LuisDonatien/TFG/README.md

# TFG
Control digital en HW de motor DC con UI Microblaze.
