LuisDonatien/TFG/Programacion/SoCNexys4/Hw/BD/SoCNexys/ip/SoCNexys_Controlador_Motores_0_0/synth/SoCNexys_Controlador_Motores_0_0.vhd

-- (c) Copyright 1995-2022 Xilinx, Inc. All rights reserved.
-- 
-- This file contains confidential and proprietary information
-- of Xilinx, Inc. and is protected under U.S. and
-- international copyright and other intellectual property
-- laws.
-- 
-- DISCLAIMER
-- This disclaimer is not a license and does not grant any
-- rights to the materials distributed herewith. Except as
-- otherwise provided in a valid license issued to you by
-- Xilinx, and to the maximum extent permitted by applicable
-- law: (1) THESE MATERIALS ARE MADE AVAILABLE "AS IS" AND
-- WITH ALL FAULTS, AND XILINX HEREBY DISCLAIMS ALL WARRANTIES
-- AND CONDITIONS, EXPRESS, IMPLIED, OR STATUTORY, INCLUDING
-- BUT NOT LIMITED TO WARRANTIES OF MERCHANTABILITY, NON-
-- INFRINGEMENT, OR FITNESS FOR ANY PARTICULAR PURPOSE; and
-- (2) Xilinx shall not be liable (whether in contract or tort,
-- including negligence, or under any other theory of
-- liability) for any loss or damage of any kind or nature
-- related to, arising under or in connection with these
-- materials, including for any direct, or any indirect,
-- special, incidental, or consequential loss or damage
-- (including loss of data, profits, goodwill, or any type of
-- loss or damage suffered as a result of any action brought
-- by a third party) even if such damage or loss was
-- reasonably foreseeable or Xilinx had been advised of the
-- possibility of the same.
-- 
-- CRITICAL APPLICATIONS
-- Xilinx products are not designed or intended to be fail-
-- safe, or for use in any application requiring fail-safe
-- performance, such as life-support or safety devices or
-- systems, Class III medical devices, nuclear facilities,
-- applications related to the deployment of airbags, or any
-- other applications that could lead to death, personal
-- injury, or severe property or environmental damage
-- (individually and collectively, "Critical
-- Applications"). Customer assumes the sole risk and
-- liability of any use of Xilinx products in Critical
-- Applications, subject only to applicable laws and
-- regulations governing limitations on product liability.
-- 
-- THIS COPYRIGHT NOTICE AND DISCLAIMER MUST BE RETAINED AS
-- PART OF THIS FILE AT ALL TIMES.
-- 
-- DO NOT MODIFY THIS FILE.

-- IP VLNV: xilinx.com:user:Controlador_Motores_BLDC:1.0
-- IP Revision: 21

LIBRARY ieee;
USE ieee.std_logic_1164.ALL;
USE ieee.numeric_std.ALL;

ENTITY SoCNexys_Controlador_Motores_0_0 IS
  PORT (
    CLK : IN STD_LOGIC;
    RESET : IN STD_LOGIC;
    A : IN STD_LOGIC;
    B : IN STD_LOGIC;
    C : IN STD_LOGIC;
    A_out : OUT STD_LOGIC;
    B_out : OUT STD_LOGIC;
    C_out : OUT STD_LOGIC;
    PWM_AH : OUT STD_LOGIC;
    PWM_AL : OUT STD_LOGIC;
    PWM_BH : OUT STD_LOGIC;
    PWM_BL : OUT STD_LOGIC;
    PWM_CH : OUT STD_LOGIC;
    PWM_CL : OUT STD_LOGIC;
    PWM_HIGH : OUT STD_LOGIC;
    PWM_LOW : OUT STD_LOGIC;
    ERROR : OUT STD_LOGIC;
    Duty_Led : OUT STD_LOGIC_VECTOR(9 DOWNTO 0);
    Intc : OUT STD_LOGIC;
    Segment : OUT STD_LOGIC_VECTOR(6 DOWNTO 0);
    Display : OUT STD_LOGIC_VECTOR(3 DOWNTO 0);
    s00_axi_aclk : IN STD_LOGIC;
    s00_axi_aresetn : IN STD_LOGIC;
    s00_axi_awaddr : IN STD_LOGIC_VECTOR(4 DOWNTO 0);
    s00_axi_awprot : IN STD_LOGIC_VECTOR(2 DOWNTO 0);
    s00_axi_awvalid : IN STD_LOGIC;
    s00_axi_awready : OUT STD_LOGIC;
    s00_axi_wdata : IN STD_LOGIC_VECTOR(31 DOWNTO 0);
    s00_axi_wstrb : IN STD_LOGIC_VECTOR(3 DOWNTO 0);
    s00_axi_wvalid : IN STD_LOGIC;
    s00_axi_wready : OUT STD_LOGIC;
    s00_axi_bresp : OUT STD_LOGIC_VECTOR(1 DOWNTO 0);
    s00_axi_bvalid : OUT STD_LOGIC;
    s00_axi_bready : IN STD_LOGIC;
    s00_axi_araddr : IN STD_LOGIC_VECTOR(4 DOWNTO 0);
    s00_axi_arprot : IN STD_LOGIC_VECTOR(2 DOWNTO 0);
    s00_axi_arvalid : IN STD_LOGIC;
    s00_axi_arready : OUT STD_LOGIC;
    s00_axi_rdata : OUT STD_LOGIC_VECTOR(31 DOWNTO 0);
    s00_axi_rresp : OUT STD_LOGIC_VECTOR(1 DOWNTO 0);
    s00_axi_rvalid : OUT STD_LOGIC;
    s00_axi_rready : IN STD_LOGIC
  );
END SoCNexys_Controlador_Motores_0_0;

ARCHITECTURE SoCNexys_Controlador_Motores_0_0_arch OF SoCNexys_Controlador_Motores_0_0 IS
  ATTRIBUTE DowngradeIPIdentifiedWarnings : STRING;
  ATTRIBUTE DowngradeIPIdentifiedWarnings OF SoCNexys_Controlador_Motores_0_0_arch: ARCHITECTURE IS "yes";
  COMPONENT Controlador_Motores_BLDC_v1_0 IS
    GENERIC (
      C_S00_AXI_DATA_WIDTH : INTEGER; -- Width of S_AXI data bus
      C_S00_AXI_ADDR_WIDTH : INTEGER; -- Width of S_AXI address bus
      CONTROLADOR : BOOLEAN;
      DIRECTO : BOOLEAN;
      KP : INTEGER;
      KI : INTEGER;
      SAMPLES : INTEGER;
      COMPLEMENTARIO : BOOLEAN;
      Duty_SIZE : INTEGER;
      DeadBand : INTEGER;
      Frecuencia : INTEGER;
      Ciclos : INTEGER
    );
    PORT (
      CLK : IN STD_LOGIC;
      RESET : IN STD_LOGIC;
      A : IN STD_LOGIC;
      B : IN STD_LOGIC;
      C : IN STD_LOGIC;
      A_out : OUT STD_LOGIC;
      B_out : OUT STD_LOGIC;
      C_out : OUT STD_LOGIC;
      PWM_AH : OUT STD_LOGIC;
      PWM_AL : OUT STD_LOGIC;
      PWM_BH : OUT STD_LOGIC;
      PWM_BL : OUT STD_LOGIC;
      PWM_CH : OUT STD_LOGIC;
      PWM_CL : OUT STD_LOGIC;
      PWM_HIGH : OUT STD_LOGIC;
      PWM_LOW : OUT STD_LOGIC;
      ERROR : OUT STD_LOGIC;
      Duty_Led : OUT STD_LOGIC_VECTOR(9 DOWNTO 0);
      Intc : OUT STD_LOGIC;
      Segment : OUT STD_LOGIC_VECTOR(6 DOWNTO 0);
      Display : OUT STD_LOGIC_VECTOR(3 DOWNTO 0);
      s00_axi_aclk : IN STD_LOGIC;
      s00_axi_aresetn : IN STD_LOGIC;
      s00_axi_awaddr : IN STD_LOGIC_VECTOR(4 DOWNTO 0);
      s00_axi_awprot : IN STD_LOGIC_VECTOR(2 DOWNTO 0);
      s00_axi_awvalid : IN STD_LOGIC;
      s00_axi_awready : OUT STD_LOGIC;
      s00_axi_wdata : IN STD_LOGIC_VECTOR(31 DOWNTO 0);
      s00_axi_wstrb : IN STD_LOGIC_VECTOR(3 DOWNTO 0);
      s00_axi_wvalid : IN STD_LOGIC;
      s00_axi_wready : OUT STD_LOGIC;
      s00_axi_bresp : OUT STD_LOGIC_VECTOR(1 DOWNTO 0);
      s00_axi_bvalid : OUT STD_LOGIC;
      s00_axi_bready : IN STD_LOGIC;
      s00_axi_araddr : IN STD_LOGIC_VECTOR(4 DOWNTO 0);
      s00_axi_arprot : IN STD_LOGIC_VECTOR(2 DOWNTO 0);
      s00_axi_arvalid : IN STD_LOGIC;
      s00_axi_arready : OUT STD_LOGIC;
      s00_axi_rdata : OUT STD_LOGIC_VECTOR(31 DOWNTO 0);
      s00_axi_rresp : OUT STD_LOGIC_VECTOR(1 DOWNTO 0);
      s00_axi_rvalid : OUT STD_LOGIC;
      s00_axi_rready : IN STD_LOGIC
    );
  END COMPONENT Controlador_Motores_BLDC_v1_0;
  ATTRIBUTE X_CORE_INFO : STRING;
  ATTRIBUTE X_CORE_INFO OF SoCNexys_Controlador_Motores_0_0_arch: ARCHITECTURE IS "Controlador_Motores_BLDC_v1_0,Vivado 2020.1";
  ATTRIBUTE CHECK_LICENSE_TYPE : STRING;
  ATTRIBUTE CHECK_LICENSE_TYPE OF SoCNexys_Controlador_Motores_0_0_arch : ARCHITECTURE IS "SoCNexys_Controlador_Motores_0_0,Controlador_Motores_BLDC_v1_0,{}";
  ATTRIBUTE CORE_GENERATION_INFO : STRING;
  ATTRIBUTE CORE_GENERATION_INFO OF SoCNexys_Controlador_Motores_0_0_arch: ARCHITECTURE IS "SoCNexys_Controlador_Motores_0_0,Controlador_Motores_BLDC_v1_0,{x_ipProduct=Vivado 2020.1,x_ipVendor=xilinx.com,x_ipLibrary=user,x_ipName=Controlador_Motores_BLDC,x_ipVersion=1.0,x_ipCoreRevision=21,x_ipLanguage=VHDL,x_ipSimLanguage=MIXED,C_S00_AXI_DATA_WIDTH=32,C_S00_AXI_ADDR_WIDTH=5,CONTROLADOR=TRUE,DIRECTO=FALSE,KP=125,KI=5,SAMPLES=40,COMPLEMENTARIO=true,Duty_SIZE=10,DeadBand=4,Frecuencia=1000,Ciclos=5}";
  ATTRIBUTE X_INTERFACE_INFO : STRING;
  ATTRIBUTE X_INTERFACE_PARAMETER : STRING;
  ATTRIBUTE X_INTERFACE_INFO OF s00_axi_rready: SIGNAL IS "xilinx.com:interface:aximm:1.0 S00_AXI RREADY";
  ATTRIBUTE X_INTERFACE_INFO OF s00_axi_rvalid: SIGNAL IS "xilinx.com:interface:aximm:1.0 S00_AXI RVALID";
  ATTRIBUTE X_INTERFACE_INFO OF s00_axi_rresp: SIGNAL IS "xilinx.com:interface:aximm:1.0 S00_AXI RRESP";
  ATTRIBUTE X_INTERFACE_INFO OF s00_axi_rdata: SIGNAL IS "xilinx.com:interface:aximm:1.0 S00_AXI RDATA";
  ATTRIBUTE X_INTERFACE_INFO OF s00_axi_arready: SIGNAL IS "xilinx.com:interface:aximm:1.0 S00_AXI ARREADY";
  ATTRIBUTE X_INTERFACE_INFO OF s00_axi_arvalid: SIGNAL IS "xilinx.com:interface:aximm:1.0 S00_AXI ARVALID";
  ATTRIBUTE X_INTERFACE_INFO OF s00_axi_arprot: SIGNAL IS "xilinx.com:interface:aximm:1.0 S00_AXI ARPROT";
  ATTRIBUTE X_INTERFACE_INFO OF s00_axi_araddr: SIGNAL IS "xilinx.com:interface:aximm:1.0 S00_AXI ARADDR";
  ATTRIBUTE X_INTERFACE_INFO OF s00_axi_bready: SIGNAL IS "xilinx.com:interface:aximm:1.0 S00_AXI BREADY";
  ATTRIBUTE X_INTERFACE_INFO OF s00_axi_bvalid: SIGNAL IS "xilinx.com:interface:aximm:1.0 S00_AXI BVALID";
  ATTRIBUTE X_INTERFACE_INFO OF s00_axi_bresp: SIGNAL IS "xilinx.com:interface:aximm:1.0 S00_AXI BRESP";
  ATTRIBUTE X_INTERFACE_INFO OF s00_axi_wready: SIGNAL IS "xilinx.com:interface:aximm:1.0 S00_AXI WREADY";
  ATTRIBUTE X_INTERFACE_INFO OF s00_axi_wvalid: SIGNAL IS "xilinx.com:interface:aximm:1.0 S00_AXI WVALID";
  ATTRIBUTE X_INTERFACE_INFO OF s00_axi_wstrb: SIGNAL IS "xilinx.com:interface:aximm:1.0 S00_AXI WSTRB";
  ATTRIBUTE X_INTERFACE_INFO OF s00_axi_wdata: SIGNAL IS "xilinx.com:interface:aximm:1.0 S00_AXI WDATA";
  ATTRIBUTE X_INTERFACE_INFO OF s00_axi_awready: SIGNAL IS "xilinx.com:interface:aximm:1.0 S00_AXI AWREADY";
  ATTRIBUTE X_INTERFACE_INFO OF s00_axi_awvalid: SIGNAL IS "xilinx.com:interface:aximm:1.0 S00_AXI AWVALID";
  ATTRIBUTE X_INTERFACE_INFO OF s00_axi_awprot: SIGNAL IS "xilinx.com:interface:aximm:1.0 S00_AXI AWPROT";
  ATTRIBUTE X_INTERFACE_PARAMETER OF s00_axi_awaddr: SIGNAL IS "XIL_INTERFACENAME S00_AXI, WIZ_DATA_WIDTH 32, WIZ_NUM_REG 6, SUPPORTS_NARROW_BURST 0, DATA_WIDTH 32, PROTOCOL AXI4LITE, FREQ_HZ 100000000, ID_WIDTH 0, ADDR_WIDTH 5, AWUSER_WIDTH 0, ARUSER_WIDTH 0, WUSER_WIDTH 0, RUSER_WIDTH 0, BUSER_WIDTH 0, READ_WRITE_MODE READ_WRITE, HAS_BURST 0, HAS_LOCK 0, HAS_PROT 1, HAS_CACHE 0, HAS_QOS 0, HAS_REGION 0, HAS_WSTRB 1, HAS_BRESP 1, HAS_RRESP 1, NUM_READ_OUTSTANDING 2, NUM_WRITE_OUTSTANDING 2, MAX_BURST_LENGTH 1, PHASE 0.0, CLK_DOMAIN /clk_wiz_0_clk_out1, NUM_" & 
"READ_THREADS 1, NUM_WRITE_THREADS 1, RUSER_BITS_PER_BYTE 0, WUSER_BITS_PER_BYTE 0, INSERT_VIP 0";
  ATTRIBUTE X_INTERFACE_INFO OF s00_axi_awaddr: SIGNAL IS "xilinx.com:interface:aximm:1.0 S00_AXI AWADDR";
  ATTRIBUTE X_INTERFACE_PARAMETER OF s00_axi_aresetn: SIGNAL IS "XIL_INTERFACENAME S00_AXI_RST, POLARITY ACTIVE_LOW, INSERT_VIP 0";
  ATTRIBUTE X_INTERFACE_INFO OF s00_axi_aresetn: SIGNAL IS "xilinx.com:signal:reset:1.0 S00_AXI_RST RST";
  ATTRIBUTE X_INTERFACE_PARAMETER OF s00_axi_aclk: SIGNAL IS "XIL_INTERFACENAME S00_AXI_CLK, ASSOCIATED_BUSIF S00_AXI, ASSOCIATED_RESET s00_axi_aresetn, FREQ_HZ 100000000, FREQ_TOLERANCE_HZ 0, PHASE 0.0, CLK_DOMAIN /clk_wiz_0_clk_out1, INSERT_VIP 0, PortWidth 1";
  ATTRIBUTE X_INTERFACE_INFO OF s00_axi_aclk: SIGNAL IS "xilinx.com:signal:clock:1.0 S00_AXI_CLK CLK";
  ATTRIBUTE X_INTERFACE_PARAMETER OF Intc: SIGNAL IS "XIL_INTERFACENAME Intc, SENSITIVITY EDGE_RISING, PortWidth 1";
  ATTRIBUTE X_INTERFACE_INFO OF Intc: SIGNAL IS "xilinx.com:signal:interrupt:1.0 Intc INTERRUPT";
  ATTRIBUTE X_INTERFACE_PARAMETER OF RESET: SIGNAL IS "XIL_INTERFACENAME RESET, POLARITY ACTIVE_HIGH, PortWidth 1, TYPE rst, INSERT_VIP 0";
  ATTRIBUTE X_INTERFACE_INFO OF RESET: SIGNAL IS "xilinx.com:signal:reset:1.0 RESET RST";
  ATTRIBUTE X_INTERFACE_PARAMETER OF CLK: SIGNAL IS "XIL_INTERFACENAME CLK, ASSOCIATED_BUSIF CLK, PortWidth 1, FREQ_HZ 100000000, FREQ_TOLERANCE_HZ 0, PHASE 0.0, CLK_DOMAIN /clk_wiz_0_clk_out1, INSERT_VIP 0";
  ATTRIBUTE X_INTERFACE_INFO OF CLK: SIGNAL IS "xilinx.com:signal:clock:1.0 CLK CLK";
BEGIN
  U0 : Controlador_Motores_BLDC_v1_0
    GENERIC MAP (
      C_S00_AXI_DATA_WIDTH => 32,
      C_S00_AXI_ADDR_WIDTH => 5,
      CONTROLADOR => true,
      DIRECTO => false,
      KP => 125,
      KI => 5,
      SAMPLES => 40,
      COMPLEMENTARIO => true,
      Duty_SIZE => 10,
      DeadBand => 4,
      Frecuencia => 1000,
      Ciclos => 5
    )
    PORT MAP (
      CLK => CLK,
      RESET => RESET,
      A => A,
      B => B,
      C => C,
      A_out => A_out,
      B_out => B_out,
      C_out => C_out,
      PWM_AH => PWM_AH,
      PWM_AL => PWM_AL,
      PWM_BH => PWM_BH,
      PWM_BL => PWM_BL,
      PWM_CH => PWM_CH,
      PWM_CL => PWM_CL,
      PWM_HIGH => PWM_HIGH,
      PWM_LOW => PWM_LOW,
      ERROR => ERROR,
      Duty_Led => Duty_Led,
      Intc => Intc,
      Segment => Segment,
      Display => Display,
      s00_axi_aclk => s00_axi_aclk,
      s00_axi_aresetn => s00_axi_aresetn,
      s00_axi_awaddr => s00_axi_awaddr,
      s00_axi_awprot => s00_axi_awprot,
      s00_axi_awvalid => s00_axi_awvalid,
      s00_axi_awready => s00_axi_awready,
      s00_axi_wdata => s00_axi_wdata,
      s00_axi_wstrb => s00_axi_wstrb,
      s00_axi_wvalid => s00_axi_wvalid,
      s00_axi_wready => s00_axi_wready,
      s00_axi_bresp => s00_axi_bresp,
      s00_axi_bvalid => s00_axi_bvalid,
      s00_axi_bready => s00_axi_bready,
      s00_axi_araddr => s00_axi_araddr,
      s00_axi_arprot => s00_axi_arprot,
      s00_axi_arvalid => s00_axi_arvalid,
      s00_axi_arready => s00_axi_arready,
      s00_axi_rdata => s00_axi_rdata,
      s00_axi_rresp => s00_axi_rresp,
      s00_axi_rvalid => s00_axi_rvalid,
      s00_axi_rready => s00_axi_rready
    );
END SoCNexys_Controlador_Motores_0_0_arch;
