LuisDonatien/TFG/Programacion/SoCNexys4/Hw/BD/SoCNexys/ip/SoCNexys_microblaze_0_0/SoCNexys_microblaze_0_0_stub.v

// Copyright 1986-2020 Xilinx, Inc. All Rights Reserved.
// --------------------------------------------------------------------------------
// Tool Version: Vivado v.2020.1 (win64) Build 2902540 Wed May 27 19:54:49 MDT 2020
// Date        : Thu Jun 23 02:34:39 2022
// Host        : LAPTOP-NOM20D60 running 64-bit major release  (build 9200)
// Command     : write_verilog -force -mode synth_stub
//               c:/GitHubTFG/TFG/Programacion/SoCNexys4/Hw/BD/SoCNexys/ip/SoCNexys_microblaze_0_0/SoCNexys_microblaze_0_0_stub.v
// Design      : SoCNexys_microblaze_0_0
// Purpose     : Stub declaration of top-level module interface
// Device      : xc7a100tcsg324-1
// --------------------------------------------------------------------------------

// This empty module with port declaration file causes synthesis tools to infer a black box for IP.
// The synthesis directives are for Synopsys Synplify support to prevent IO buffer insertion.
// Please paste the declaration into a Verilog source file or add the file as an additional source.
(* x_core_info = "MicroBlaze,Vivado 2020.1" *)
module SoCNexys_microblaze_0_0(Clk, Reset, Interrupt, Interrupt_Address, 
  Interrupt_Ack, Instr_Addr, Instr, IFetch, I_AS, IReady, IWAIT, ICE, IUE, Data_Addr, Data_Read, 
  Data_Write, D_AS, Read_Strobe, Write_Strobe, DReady, DWait, DCE, DUE, Byte_Enable, M_AXI_DP_AWADDR, 
  M_AXI_DP_AWPROT, M_AXI_DP_AWVALID, M_AXI_DP_AWREADY, M_AXI_DP_WDATA, M_AXI_DP_WSTRB, 
  M_AXI_DP_WVALID, M_AXI_DP_WREADY, M_AXI_DP_BRESP, M_AXI_DP_BVALID, M_AXI_DP_BREADY, 
  M_AXI_DP_ARADDR, M_AXI_DP_ARPROT, M_AXI_DP_ARVALID, M_AXI_DP_ARREADY, M_AXI_DP_RDATA, 
  M_AXI_DP_RRESP, M_AXI_DP_RVALID, M_AXI_DP_RREADY, Dbg_Clk, Dbg_TDI, Dbg_TDO, Dbg_Reg_En, 
  Dbg_Shift, Dbg_Capture, Dbg_Update, Debug_Rst, Dbg_Disable)
/* synthesis syn_black_box black_box_pad_pin="Clk,Reset,Interrupt,Interrupt_Address[0:31],Interrupt_Ack[0:1],Instr_Addr[0:31],Instr[0:31],IFetch,I_AS,IReady,IWAIT,ICE,IUE,Data_Addr[0:31],Data_Read[0:31],Data_Write[0:31],D_AS,Read_Strobe,Write_Strobe,DReady,DWait,DCE,DUE,Byte_Enable[0:3],M_AXI_DP_AWADDR[31:0],M_AXI_DP_AWPROT[2:0],M_AXI_DP_AWVALID,M_AXI_DP_AWREADY,M_AXI_DP_WDATA[31:0],M_AXI_DP_WSTRB[3:0],M_AXI_DP_WVALID,M_AXI_DP_WREADY,M_AXI_DP_BRESP[1:0],M_AXI_DP_BVALID,M_AXI_DP_BREADY,M_AXI_DP_ARADDR[31:0],M_AXI_DP_ARPROT[2:0],M_AXI_DP_ARVALID,M_AXI_DP_ARREADY,M_AXI_DP_RDATA[31:0],M_AXI_DP_RRESP[1:0],M_AXI_DP_RVALID,M_AXI_DP_RREADY,Dbg_Clk,Dbg_TDI,Dbg_TDO,Dbg_Reg_En[0:7],Dbg_Shift,Dbg_Capture,Dbg_Update,Debug_Rst,Dbg_Disable" */;
  input Clk;
  input Reset;
  input Interrupt;
  input [0:31]Interrupt_Address;
  output [0:1]Interrupt_Ack;
  output [0:31]Instr_Addr;
  input [0:31]Instr;
  output IFetch;
  output I_AS;
  input IReady;
  input IWAIT;
  input ICE;
  input IUE;
  output [0:31]Data_Addr;
  input [0:31]Data_Read;
  output [0:31]Data_Write;
  output D_AS;
  output Read_Strobe;
  output Write_Strobe;
  input DReady;
  input DWait;
  input DCE;
  input DUE;
  output [0:3]Byte_Enable;
  output [31:0]M_AXI_DP_AWADDR;
  output [2:0]M_AXI_DP_AWPROT;
  output M_AXI_DP_AWVALID;
  input M_AXI_DP_AWREADY;
  output [31:0]M_AXI_DP_WDATA;
  output [3:0]M_AXI_DP_WSTRB;
  output M_AXI_DP_WVALID;
  input M_AXI_DP_WREADY;
  input [1:0]M_AXI_DP_BRESP;
  input M_AXI_DP_BVALID;
  output M_AXI_DP_BREADY;
  output [31:0]M_AXI_DP_ARADDR;
  output [2:0]M_AXI_DP_ARPROT;
  output M_AXI_DP_ARVALID;
  input M_AXI_DP_ARREADY;
  input [31:0]M_AXI_DP_RDATA;
  input [1:0]M_AXI_DP_RRESP;
  input M_AXI_DP_RVALID;
  output M_AXI_DP_RREADY;
  input Dbg_Clk;
  input Dbg_TDI;
  output Dbg_TDO;
  input [0:7]Dbg_Reg_En;
  input Dbg_Shift;
  input Dbg_Capture;
  input Dbg_Update;
  input Debug_Rst;
  input Dbg_Disable;
endmodule
