LuisDonatien/TFG/Programacion/SoCNexys4/Hw/BD/SoCNexys/ip/SoCNexys_clk_wiz_0_0/SoCNexys_clk_wiz_0_0_stub.vhdl

-- Copyright 1986-2020 Xilinx, Inc. All Rights Reserved.
-- --------------------------------------------------------------------------------
-- Tool Version: Vivado v.2020.1 (win64) Build 2902540 Wed May 27 19:54:49 MDT 2020
-- Date        : Thu Jun 23 02:34:01 2022
-- Host        : LAPTOP-NOM20D60 running 64-bit major release  (build 9200)
-- Command     : write_vhdl -force -mode synth_stub
--               c:/GitHubTFG/TFG/Programacion/SoCNexys4/Hw/BD/SoCNexys/ip/SoCNexys_clk_wiz_0_0/SoCNexys_clk_wiz_0_0_stub.vhdl
-- Design      : SoCNexys_clk_wiz_0_0
-- Purpose     : Stub declaration of top-level module interface
-- Device      : xc7a100tcsg324-1
-- --------------------------------------------------------------------------------
library IEEE;
use IEEE.STD_LOGIC_1164.ALL;

entity SoCNexys_clk_wiz_0_0 is
  Port ( 
    clk_out1 : out STD_LOGIC;
    reset : in STD_LOGIC;
    locked : out STD_LOGIC;
    clk_in1 : in STD_LOGIC
  );

end SoCNexys_clk_wiz_0_0;

architecture stub of SoCNexys_clk_wiz_0_0 is
attribute syn_black_box : boolean;
attribute black_box_pad_pin : string;
attribute syn_black_box of stub : architecture is true;
attribute black_box_pad_pin of stub : architecture is "clk_out1,reset,locked,clk_in1";
begin
end;
