LuisDonatien/TFG/Programacion/SoCBasys3/Hw/BD/SoC/ip/SoC_axi_uartlite_0_0/SoC_axi_uartlite_0_0_stub.v

// Copyright 1986-2020 Xilinx, Inc. All Rights Reserved.
// --------------------------------------------------------------------------------
// Tool Version: Vivado v.2020.1 (win64) Build 2902540 Wed May 27 19:54:49 MDT 2020
// Date        : Thu Jun  2 19:59:40 2022
// Host        : LAPTOP-NOM20D60 running 64-bit major release  (build 9200)
// Command     : write_verilog -force -mode synth_stub
//               c:/GitHubTFG/TFG/Programacion/SoCBasys3/BD/SoC/ip/SoC_axi_uartlite_0_0/SoC_axi_uartlite_0_0_stub.v
// Design      : SoC_axi_uartlite_0_0
// Purpose     : Stub declaration of top-level module interface
// Device      : xc7a35tcpg236-1
// --------------------------------------------------------------------------------

// This empty module with port declaration file causes synthesis tools to infer a black box for IP.
// The synthesis directives are for Synopsys Synplify support to prevent IO buffer insertion.
// Please paste the declaration into a Verilog source file or add the file as an additional source.
(* x_core_info = "axi_uartlite,Vivado 2020.1" *)
module SoC_axi_uartlite_0_0(s_axi_aclk, s_axi_aresetn, interrupt, 
  s_axi_awaddr, s_axi_awvalid, s_axi_awready, s_axi_wdata, s_axi_wstrb, s_axi_wvalid, 
  s_axi_wready, s_axi_bresp, s_axi_bvalid, s_axi_bready, s_axi_araddr, s_axi_arvalid, 
  s_axi_arready, s_axi_rdata, s_axi_rresp, s_axi_rvalid, s_axi_rready, rx, tx)
/* synthesis syn_black_box black_box_pad_pin="s_axi_aclk,s_axi_aresetn,interrupt,s_axi_awaddr[3:0],s_axi_awvalid,s_axi_awready,s_axi_wdata[31:0],s_axi_wstrb[3:0],s_axi_wvalid,s_axi_wready,s_axi_bresp[1:0],s_axi_bvalid,s_axi_bready,s_axi_araddr[3:0],s_axi_arvalid,s_axi_arready,s_axi_rdata[31:0],s_axi_rresp[1:0],s_axi_rvalid,s_axi_rready,rx,tx" */;
  input s_axi_aclk;
  input s_axi_aresetn;
  output interrupt;
  input [3:0]s_axi_awaddr;
  input s_axi_awvalid;
  output s_axi_awready;
  input [31:0]s_axi_wdata;
  input [3:0]s_axi_wstrb;
  input s_axi_wvalid;
  output s_axi_wready;
  output [1:0]s_axi_bresp;
  output s_axi_bvalid;
  input s_axi_bready;
  input [3:0]s_axi_araddr;
  input s_axi_arvalid;
  output s_axi_arready;
  output [31:0]s_axi_rdata;
  output [1:0]s_axi_rresp;
  output s_axi_rvalid;
  input s_axi_rready;
  input rx;
  output tx;
endmodule
