LuisDonatien/TFG/Programacion/SoCNexys4/Hw/BD/SoCNexys/ip/SoCNexys_Controlador_Motores_0_0/SoCNexys_Controlador_Motores_0_0_sim_netlist.v

// Copyright 1986-2020 Xilinx, Inc. All Rights Reserved.
// --------------------------------------------------------------------------------
// Tool Version: Vivado v.2020.1 (win64) Build 2902540 Wed May 27 19:54:49 MDT 2020
// Date        : Thu Jun 23 02:48:42 2022
// Host        : LAPTOP-NOM20D60 running 64-bit major release  (build 9200)
// Command     : write_verilog -force -mode funcsim
//               c:/GitHubTFG/TFG/Programacion/SoCNexys4/Hw/BD/SoCNexys/ip/SoCNexys_Controlador_Motores_0_0/SoCNexys_Controlador_Motores_0_0_sim_netlist.v
// Design      : SoCNexys_Controlador_Motores_0_0
// Purpose     : This verilog netlist is a functional simulation representation of the design and should not be modified
//               or synthesized. This netlist cannot be used for SDF annotated simulation.
// Device      : xc7a100tcsg324-1
// --------------------------------------------------------------------------------
`timescale 1 ps / 1 ps

(* CHECK_LICENSE_TYPE = "SoCNexys_Controlador_Motores_0_0,Controlador_Motores_BLDC_v1_0,{}" *) (* downgradeipidentifiedwarnings = "yes" *) (* x_core_info = "Controlador_Motores_BLDC_v1_0,Vivado 2020.1" *) 
(* NotValidForBitStream *)
module SoCNexys_Controlador_Motores_0_0
   (CLK,
    RESET,
    A,
    B,
    C,
    A_out,
    B_out,
    C_out,
    PWM_AH,
    PWM_AL,
    PWM_BH,
    PWM_BL,
    PWM_CH,
    PWM_CL,
    PWM_HIGH,
    PWM_LOW,
    ERROR,
    Duty_Led,
    Intc,
    Segment,
    Display,
    s00_axi_aclk,
    s00_axi_aresetn,
    s00_axi_awaddr,
    s00_axi_awprot,
    s00_axi_awvalid,
    s00_axi_awready,
    s00_axi_wdata,
    s00_axi_wstrb,
    s00_axi_wvalid,
    s00_axi_wready,
    s00_axi_bresp,
    s00_axi_bvalid,
    s00_axi_bready,
    s00_axi_araddr,
    s00_axi_arprot,
    s00_axi_arvalid,
    s00_axi_arready,
    s00_axi_rdata,
    s00_axi_rresp,
    s00_axi_rvalid,
    s00_axi_rready);
  (* x_interface_info = "xilinx.com:signal:clock:1.0 CLK CLK" *) (* x_interface_parameter = "XIL_INTERFACENAME CLK, ASSOCIATED_BUSIF CLK, PortWidth 1, FREQ_HZ 100000000, FREQ_TOLERANCE_HZ 0, PHASE 0.0, CLK_DOMAIN /clk_wiz_0_clk_out1, INSERT_VIP 0" *) input CLK;
  (* x_interface_info = "xilinx.com:signal:reset:1.0 RESET RST" *) (* x_interface_parameter = "XIL_INTERFACENAME RESET, POLARITY ACTIVE_HIGH, PortWidth 1, TYPE rst, INSERT_VIP 0" *) input RESET;
  input A;
  input B;
  input C;
  output A_out;
  output B_out;
  output C_out;
  output PWM_AH;
  output PWM_AL;
  output PWM_BH;
  output PWM_BL;
  output PWM_CH;
  output PWM_CL;
  output PWM_HIGH;
  output PWM_LOW;
  output ERROR;
  output [9:0]Duty_Led;
  (* x_interface_info = "xilinx.com:signal:interrupt:1.0 Intc INTERRUPT" *) (* x_interface_parameter = "XIL_INTERFACENAME Intc, SENSITIVITY EDGE_RISING, PortWidth 1" *) output Intc;
  output [6:0]Segment;
  output [3:0]Display;
  (* x_interface_info = "xilinx.com:signal:clock:1.0 S00_AXI_CLK CLK" *) (* x_interface_parameter = "XIL_INTERFACENAME S00_AXI_CLK, ASSOCIATED_BUSIF S00_AXI, ASSOCIATED_RESET s00_axi_aresetn, FREQ_HZ 100000000, FREQ_TOLERANCE_HZ 0, PHASE 0.0, CLK_DOMAIN /clk_wiz_0_clk_out1, INSERT_VIP 0, PortWidth 1" *) input s00_axi_aclk;
  (* x_interface_info = "xilinx.com:signal:reset:1.0 S00_AXI_RST RST" *) (* x_interface_parameter = "XIL_INTERFACENAME S00_AXI_RST, POLARITY ACTIVE_LOW, INSERT_VIP 0" *) input s00_axi_aresetn;
  (* x_interface_info = "xilinx.com:interface:aximm:1.0 S00_AXI AWADDR" *) (* x_interface_parameter = "XIL_INTERFACENAME S00_AXI, WIZ_DATA_WIDTH 32, WIZ_NUM_REG 6, SUPPORTS_NARROW_BURST 0, DATA_WIDTH 32, PROTOCOL AXI4LITE, FREQ_HZ 100000000, ID_WIDTH 0, ADDR_WIDTH 5, AWUSER_WIDTH 0, ARUSER_WIDTH 0, WUSER_WIDTH 0, RUSER_WIDTH 0, BUSER_WIDTH 0, READ_WRITE_MODE READ_WRITE, HAS_BURST 0, HAS_LOCK 0, HAS_PROT 1, HAS_CACHE 0, HAS_QOS 0, HAS_REGION 0, HAS_WSTRB 1, HAS_BRESP 1, HAS_RRESP 1, NUM_READ_OUTSTANDING 2, NUM_WRITE_OUTSTANDING 2, MAX_BURST_LENGTH 1, PHASE 0.0, CLK_DOMAIN /clk_wiz_0_clk_out1, NUM_READ_THREADS 1, NUM_WRITE_THREADS 1, RUSER_BITS_PER_BYTE 0, WUSER_BITS_PER_BYTE 0, INSERT_VIP 0" *) input [4:0]s00_axi_awaddr;
  (* x_interface_info = "xilinx.com:interface:aximm:1.0 S00_AXI AWPROT" *) input [2:0]s00_axi_awprot;
  (* x_interface_info = "xilinx.com:interface:aximm:1.0 S00_AXI AWVALID" *) input s00_axi_awvalid;
  (* x_interface_info = "xilinx.com:interface:aximm:1.0 S00_AXI AWREADY" *) output s00_axi_awready;
  (* x_interface_info = "xilinx.com:interface:aximm:1.0 S00_AXI WDATA" *) input [31:0]s00_axi_wdata;
  (* x_interface_info = "xilinx.com:interface:aximm:1.0 S00_AXI WSTRB" *) input [3:0]s00_axi_wstrb;
  (* x_interface_info = "xilinx.com:interface:aximm:1.0 S00_AXI WVALID" *) input s00_axi_wvalid;
  (* x_interface_info = "xilinx.com:interface:aximm:1.0 S00_AXI WREADY" *) output s00_axi_wready;
  (* x_interface_info = "xilinx.com:interface:aximm:1.0 S00_AXI BRESP" *) output [1:0]s00_axi_bresp;
  (* x_interface_info = "xilinx.com:interface:aximm:1.0 S00_AXI BVALID" *) output s00_axi_bvalid;
  (* x_interface_info = "xilinx.com:interface:aximm:1.0 S00_AXI BREADY" *) input s00_axi_bready;
  (* x_interface_info = "xilinx.com:interface:aximm:1.0 S00_AXI ARADDR" *) input [4:0]s00_axi_araddr;
  (* x_interface_info = "xilinx.com:interface:aximm:1.0 S00_AXI ARPROT" *) input [2:0]s00_axi_arprot;
  (* x_interface_info = "xilinx.com:interface:aximm:1.0 S00_AXI ARVALID" *) input s00_axi_arvalid;
  (* x_interface_info = "xilinx.com:interface:aximm:1.0 S00_AXI ARREADY" *) output s00_axi_arready;
  (* x_interface_info = "xilinx.com:interface:aximm:1.0 S00_AXI RDATA" *) output [31:0]s00_axi_rdata;
  (* x_interface_info = "xilinx.com:interface:aximm:1.0 S00_AXI RRESP" *) output [1:0]s00_axi_rresp;
  (* x_interface_info = "xilinx.com:interface:aximm:1.0 S00_AXI RVALID" *) output s00_axi_rvalid;
  (* x_interface_info = "xilinx.com:interface:aximm:1.0 S00_AXI RREADY" *) input s00_axi_rready;

  wire A;
  wire A_out;
  wire B;
  wire B_out;
  wire C;
  wire CLK;
  wire C_out;
  wire [3:0]Display;
  wire [9:0]Duty_Led;
  wire ERROR;
  wire Intc;
  wire PWM_AH;
  wire PWM_AL;
  wire PWM_BH;
  wire PWM_BL;
  wire PWM_CH;
  wire PWM_CL;
  wire PWM_HIGH;
  wire PWM_LOW;
  wire RESET;
  wire [6:0]Segment;
  wire s00_axi_aclk;
  wire [4:0]s00_axi_araddr;
  wire s00_axi_aresetn;
  wire [2:0]s00_axi_arprot;
  wire s00_axi_arready;
  wire s00_axi_arvalid;
  wire [4:0]s00_axi_awaddr;
  wire [2:0]s00_axi_awprot;
  wire s00_axi_awready;
  wire s00_axi_awvalid;
  wire s00_axi_bready;
  wire [1:0]s00_axi_bresp;
  wire s00_axi_bvalid;
  wire [31:0]s00_axi_rdata;
  wire s00_axi_rready;
  wire [1:0]s00_axi_rresp;
  wire s00_axi_rvalid;
  wire [31:0]s00_axi_wdata;
  wire s00_axi_wready;
  wire [3:0]s00_axi_wstrb;
  wire s00_axi_wvalid;

  (* COMPLEMENTARIO = "TRUE" *) 
  (* CONTROLADOR = "TRUE" *) 
  (* C_S00_AXI_ADDR_WIDTH = "5" *) 
  (* C_S00_AXI_DATA_WIDTH = "32" *) 
  (* Ciclos = "5" *) 
  (* DIRECTO = "FALSE" *) 
  (* DeadBand = "4" *) 
  (* Duty_SIZE = "10" *) 
  (* Frecuencia = "1000" *) 
  (* KI = "5" *) 
  (* KP = "125" *) 
  (* SAMPLES = "40" *) 
  SoCNexys_Controlador_Motores_0_0_Controlador_Motores_BLDC_v1_0 U0
       (.A(A),
        .A_out(A_out),
        .B(B),
        .B_out(B_out),
        .C(C),
        .CLK(CLK),
        .C_out(C_out),
        .Display(Display),
        .Duty_Led(Duty_Led),
        .ERROR(ERROR),
        .Intc(Intc),
        .PWM_AH(PWM_AH),
        .PWM_AL(PWM_AL),
        .PWM_BH(PWM_BH),
        .PWM_BL(PWM_BL),
        .PWM_CH(PWM_CH),
        .PWM_CL(PWM_CL),
        .PWM_HIGH(PWM_HIGH),
        .PWM_LOW(PWM_LOW),
        .RESET(RESET),
        .Segment(Segment),
        .s00_axi_aclk(s00_axi_aclk),
        .s00_axi_araddr(s00_axi_araddr),
        .s00_axi_aresetn(s00_axi_aresetn),
        .s00_axi_arprot(s00_axi_arprot),
        .s00_axi_arready(s00_axi_arready),
        .s00_axi_arvalid(s00_axi_arvalid),
        .s00_axi_awaddr(s00_axi_awaddr),
        .s00_axi_awprot(s00_axi_awprot),
        .s00_axi_awready(s00_axi_awready),
        .s00_axi_awvalid(s00_axi_awvalid),
        .s00_axi_bready(s00_axi_bready),
        .s00_axi_bresp(s00_axi_bresp),
        .s00_axi_bvalid(s00_axi_bvalid),
        .s00_axi_rdata(s00_axi_rdata),
        .s00_axi_rready(s00_axi_rready),
        .s00_axi_rresp(s00_axi_rresp),
        .s00_axi_rvalid(s00_axi_rvalid),
        .s00_axi_wdata(s00_axi_wdata),
        .s00_axi_wready(s00_axi_wready),
        .s00_axi_wstrb(s00_axi_wstrb),
        .s00_axi_wvalid(s00_axi_wvalid));
endmodule

(* ORIG_REF_NAME = "CLOCK_DISPLAY" *) 
module SoCNexys_Controlador_Motores_0_0_CLOCK_DISPLAY
   (Segment,
    STEP_s,
    \STEP_reg[0]_0 ,
    \STEP_reg[1]_0 ,
    \STEP_reg[0]_1 ,
    Display,
    \STEP_reg[1]_1 ,
    \STEP_reg[1]_2 ,
    \STEP_reg[1]_3 ,
    \Segment[6] ,
    \Segment[6]_0 ,
    \Segment[6]_1 ,
    Segment_0_sp_1,
    \Segment[0]_0 ,
    \Segment[0]_1 ,
    \Segment[3] ,
    \Segment[3]_0 ,
    \Segment[3]_1 ,
    Q,
    \Segment[6]_2 ,
    CO,
    Digit12_out,
    Segment_1_sp_1,
    \Segment[4] ,
    CLK);
  output [2:0]Segment;
  output [1:0]STEP_s;
  output \STEP_reg[0]_0 ;
  output \STEP_reg[1]_0 ;
  output \STEP_reg[0]_1 ;
  output [3:0]Display;
  output \STEP_reg[1]_1 ;
  output \STEP_reg[1]_2 ;
  output \STEP_reg[1]_3 ;
  input \Segment[6] ;
  input \Segment[6]_0 ;
  input \Segment[6]_1 ;
  input Segment_0_sp_1;
  input \Segment[0]_0 ;
  input \Segment[0]_1 ;
  input \Segment[3] ;
  input \Segment[3]_0 ;
  input \Segment[3]_1 ;
  input [1:0]Q;
  input [0:0]\Segment[6]_2 ;
  input [0:0]CO;
  input [3:0]Digit12_out;
  input Segment_1_sp_1;
  input \Segment[4] ;
  input CLK;

  wire CLK;
  wire [0:0]CO;
  wire [3:0]Digit12_out;
  wire [3:0]Display;
  wire [1:0]Q;
  wire \STEP[0]_i_11_n_0 ;
  wire \STEP[0]_i_12_n_0 ;
  wire \STEP[0]_i_13_n_0 ;
  wire \STEP[0]_i_14_n_0 ;
  wire \STEP[0]_i_15_n_0 ;
  wire \STEP[0]_i_16_n_0 ;
  wire \STEP[0]_i_17_n_0 ;
  wire \STEP[0]_i_18_n_0 ;
  wire \STEP[0]_i_19_n_0 ;
  wire \STEP[0]_i_1_n_0 ;
  wire \STEP[0]_i_20_n_0 ;
  wire \STEP[0]_i_21_n_0 ;
  wire \STEP[0]_i_22_n_0 ;
  wire \STEP[0]_i_23_n_0 ;
  wire \STEP[0]_i_24_n_0 ;
  wire \STEP[0]_i_2_n_0 ;
  wire \STEP[0]_i_4_n_0 ;
  wire \STEP[0]_i_6_n_0 ;
  wire \STEP[0]_i_7_n_0 ;
  wire \STEP[0]_i_8_n_0 ;
  wire \STEP[0]_i_9_n_0 ;
  wire \STEP[1]_i_10_n_0 ;
  wire \STEP[1]_i_11_n_0 ;
  wire \STEP[1]_i_12_n_0 ;
  wire \STEP[1]_i_13_n_0 ;
  wire \STEP[1]_i_14_n_0 ;
  wire \STEP[1]_i_15_n_0 ;
  wire \STEP[1]_i_17_n_0 ;
  wire \STEP[1]_i_18_n_0 ;
  wire \STEP[1]_i_19_n_0 ;
  wire \STEP[1]_i_1_n_0 ;
  wire \STEP[1]_i_20_n_0 ;
  wire \STEP[1]_i_22_n_0 ;
  wire \STEP[1]_i_23_n_0 ;
  wire \STEP[1]_i_24_n_0 ;
  wire \STEP[1]_i_25_n_0 ;
  wire \STEP[1]_i_26_n_0 ;
  wire \STEP[1]_i_27_n_0 ;
  wire \STEP[1]_i_28_n_0 ;
  wire \STEP[1]_i_30_n_0 ;
  wire \STEP[1]_i_31_n_0 ;
  wire \STEP[1]_i_32_n_0 ;
  wire \STEP[1]_i_33_n_0 ;
  wire \STEP[1]_i_34_n_0 ;
  wire \STEP[1]_i_35_n_0 ;
  wire \STEP[1]_i_37_n_0 ;
  wire \STEP[1]_i_38_n_0 ;
  wire \STEP[1]_i_39_n_0 ;
  wire \STEP[1]_i_40_n_0 ;
  wire \STEP[1]_i_41_n_0 ;
  wire \STEP[1]_i_42_n_0 ;
  wire \STEP[1]_i_43_n_0 ;
  wire \STEP[1]_i_44_n_0 ;
  wire \STEP[1]_i_45_n_0 ;
  wire \STEP[1]_i_46_n_0 ;
  wire \STEP[1]_i_47_n_0 ;
  wire \STEP[1]_i_48_n_0 ;
  wire \STEP[1]_i_49_n_0 ;
  wire \STEP[1]_i_4_n_0 ;
  wire \STEP[1]_i_50_n_0 ;
  wire \STEP[1]_i_51_n_0 ;
  wire \STEP[1]_i_52_n_0 ;
  wire \STEP[1]_i_53_n_0 ;
  wire \STEP[1]_i_54_n_0 ;
  wire \STEP[1]_i_55_n_0 ;
  wire \STEP[1]_i_56_n_0 ;
  wire \STEP[1]_i_57_n_0 ;
  wire \STEP[1]_i_58_n_0 ;
  wire \STEP[1]_i_59_n_0 ;
  wire \STEP[1]_i_6_n_0 ;
  wire \STEP[1]_i_8_n_0 ;
  wire \STEP[1]_i_9_n_0 ;
  wire \STEP_reg[0]_0 ;
  wire \STEP_reg[0]_1 ;
  wire \STEP_reg[0]_i_10_n_0 ;
  wire \STEP_reg[0]_i_10_n_1 ;
  wire \STEP_reg[0]_i_10_n_2 ;
  wire \STEP_reg[0]_i_10_n_3 ;
  wire \STEP_reg[0]_i_3_n_0 ;
  wire \STEP_reg[0]_i_3_n_1 ;
  wire \STEP_reg[0]_i_3_n_2 ;
  wire \STEP_reg[0]_i_3_n_3 ;
  wire \STEP_reg[0]_i_5_n_0 ;
  wire \STEP_reg[0]_i_5_n_1 ;
  wire \STEP_reg[0]_i_5_n_2 ;
  wire \STEP_reg[0]_i_5_n_3 ;
  wire \STEP_reg[1]_0 ;
  wire \STEP_reg[1]_1 ;
  wire \STEP_reg[1]_2 ;
  wire \STEP_reg[1]_3 ;
  wire \STEP_reg[1]_i_16_n_0 ;
  wire \STEP_reg[1]_i_16_n_1 ;
  wire \STEP_reg[1]_i_16_n_2 ;
  wire \STEP_reg[1]_i_16_n_3 ;
  wire \STEP_reg[1]_i_21_n_0 ;
  wire \STEP_reg[1]_i_21_n_1 ;
  wire \STEP_reg[1]_i_21_n_2 ;
  wire \STEP_reg[1]_i_21_n_3 ;
  wire \STEP_reg[1]_i_29_n_0 ;
  wire \STEP_reg[1]_i_29_n_1 ;
  wire \STEP_reg[1]_i_29_n_2 ;
  wire \STEP_reg[1]_i_29_n_3 ;
  wire \STEP_reg[1]_i_36_n_0 ;
  wire \STEP_reg[1]_i_36_n_1 ;
  wire \STEP_reg[1]_i_36_n_2 ;
  wire \STEP_reg[1]_i_36_n_3 ;
  wire \STEP_reg[1]_i_3_n_1 ;
  wire \STEP_reg[1]_i_3_n_2 ;
  wire \STEP_reg[1]_i_3_n_3 ;
  wire \STEP_reg[1]_i_5_n_0 ;
  wire \STEP_reg[1]_i_5_n_1 ;
  wire \STEP_reg[1]_i_5_n_2 ;
  wire \STEP_reg[1]_i_5_n_3 ;
  wire \STEP_reg[1]_i_7_n_0 ;
  wire \STEP_reg[1]_i_7_n_1 ;
  wire \STEP_reg[1]_i_7_n_2 ;
  wire \STEP_reg[1]_i_7_n_3 ;
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
  wire \ltOp_inferred__2/i__carry__1_n_2 ;
  wire \ltOp_inferred__2/i__carry__1_n_3 ;
  wire \ltOp_inferred__2/i__carry_n_0 ;
  wire \ltOp_inferred__2/i__carry_n_1 ;
  wire \ltOp_inferred__2/i__carry_n_2 ;
  wire \ltOp_inferred__2/i__carry_n_3 ;
  wire [3:0]\NLW_STEP_reg[0]_i_10_O_UNCONNECTED ;
  wire [3:0]\NLW_STEP_reg[0]_i_3_O_UNCONNECTED ;
  wire [3:0]\NLW_STEP_reg[0]_i_5_O_UNCONNECTED ;
  wire [3:0]\NLW_STEP_reg[1]_i_16_O_UNCONNECTED ;
  wire [3:1]\NLW_STEP_reg[1]_i_2_CO_UNCONNECTED ;
  wire [3:0]\NLW_STEP_reg[1]_i_2_O_UNCONNECTED ;
  wire [3:0]\NLW_STEP_reg[1]_i_21_O_UNCONNECTED ;
  wire [3:0]\NLW_STEP_reg[1]_i_29_O_UNCONNECTED ;
  wire [3:0]\NLW_STEP_reg[1]_i_3_O_UNCONNECTED ;
  wire [3:0]\NLW_STEP_reg[1]_i_36_O_UNCONNECTED ;
  wire [3:0]\NLW_STEP_reg[1]_i_5_O_UNCONNECTED ;
  wire [3:0]\NLW_STEP_reg[1]_i_7_O_UNCONNECTED ;
  wire [3:3]\NLW_counter_reg[28]_i_1_CO_UNCONNECTED ;
  wire [3:0]NLW_geqOp_carry_O_UNCONNECTED;
  wire [3:0]NLW_geqOp_carry__0_O_UNCONNECTED;
  wire [3:0]NLW_geqOp_carry__1_O_UNCONNECTED;
  wire [3:0]NLW_geqOp_carry__2_O_UNCONNECTED;
  wire [3:0]\NLW_geqOp_inferred__1/i__carry_O_UNCONNECTED ;
  wire [3:0]\NLW_geqOp_inferred__1/i__carry__0_O_UNCONNECTED ;
  wire [3:0]\NLW_geqOp_inferred__1/i__carry__1_O_UNCONNECTED ;
  wire [3:0]\NLW_geqOp_inferred__1/i__carry__2_O_UNCONNECTED ;
  wire [3:0]\NLW_ltOp_inferred__0/i__carry_O_UNCONNECTED ;
  wire [3:0]\NLW_ltOp_inferred__0/i__carry__0_O_UNCONNECTED ;
  wire [3:0]\NLW_ltOp_inferred__0/i__carry__1_O_UNCONNECTED ;
  wire [3:0]\NLW_ltOp_inferred__2/i__carry_O_UNCONNECTED ;
  wire [3:0]\NLW_ltOp_inferred__2/i__carry__0_O_UNCONNECTED ;
  wire [3:0]\NLW_ltOp_inferred__2/i__carry__1_O_UNCONNECTED ;
  wire [3:1]\NLW_ltOp_inferred__2/i__carry__2_CO_UNCONNECTED ;
  wire [3:0]\NLW_ltOp_inferred__2/i__carry__2_O_UNCONNECTED ;

  assign Segment_0_sn_1 = Segment_0_sp_1;
  assign Segment_1_sn_1 = Segment_1_sp_1;
  (* SOFT_HLUTNM = "soft_lutpair32" *) 
  LUT2 #(
    .INIT(4'h7)) 
    \Display[0]_INST_0 
       (.I0(STEP_s[0]),
        .I1(STEP_s[1]),
        .O(Display[0]));
  (* SOFT_HLUTNM = "soft_lutpair33" *) 
  LUT2 #(
    .INIT(4'hB)) 
    \Display[1]_INST_0 
       (.I0(STEP_s[0]),
        .I1(STEP_s[1]),
        .O(Display[1]));
  (* SOFT_HLUTNM = "soft_lutpair30" *) 
  LUT2 #(
    .INIT(4'hB)) 
    \Display[2]_INST_0 
       (.I0(STEP_s[1]),
        .I1(STEP_s[0]),
        .O(Display[2]));
  (* SOFT_HLUTNM = "soft_lutpair31" *) 
  LUT2 #(
    .INIT(4'hE)) 
    \Display[3]_INST_0 
       (.I0(STEP_s[0]),
        .I1(STEP_s[1]),
        .O(Display[3]));
  LUT6 #(
    .INIT(64'h4444555544445444)) 
    \STEP[0]_i_1 
       (.I0(ltOp),
        .I1(\STEP[0]_i_2_n_0 ),
        .I2(\STEP_reg[0]_i_3_n_0 ),
        .I3(geqOp),
        .I4(\STEP[0]_i_4_n_0 ),
        .I5(STEP_s[0]),
        .O(\STEP[0]_i_1_n_0 ));
  LUT2 #(
    .INIT(4'h1)) 
    \STEP[0]_i_11 
       (.I0(counter_reg[21]),
        .I1(counter_reg[20]),
        .O(\STEP[0]_i_11_n_0 ));
  LUT1 #(
    .INIT(2'h1)) 
    \STEP[0]_i_12 
       (.I0(counter_reg[19]),
        .O(\STEP[0]_i_12_n_0 ));
  LUT2 #(
    .INIT(4'h1)) 
    \STEP[0]_i_13 
       (.I0(counter_reg[23]),
        .I1(counter_reg[22]),
        .O(\STEP[0]_i_13_n_0 ));
  LUT2 #(
    .INIT(4'h2)) 
    \STEP[0]_i_14 
       (.I0(counter_reg[20]),
        .I1(counter_reg[21]),
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
        .CYINIT(1'b0),
        .DI({1'b0,1'b0,1'b0,1'b0}),
        .O(\NLW_STEP_reg[0]_i_3_O_UNCONNECTED [3:0]),
        .S({\STEP[0]_i_6_n_0 ,\STEP[0]_i_7_n_0 ,\STEP[0]_i_8_n_0 ,\STEP[0]_i_9_n_0 }));
  (* COMPARATOR_THRESHOLD = "11" *) 
  CARRY4 \STEP_reg[0]_i_5 
       (.CI(\STEP_reg[0]_i_10_n_0 ),
        .CO({\STEP_reg[0]_i_5_n_0 ,\STEP_reg[0]_i_5_n_1 ,\STEP_reg[0]_i_5_n_2 ,\STEP_reg[0]_i_5_n_3 }),
        .CYINIT(1'b0),
        .DI({1'b0,\STEP[0]_i_11_n_0 ,\STEP[0]_i_12_n_0 ,1'b0}),
        .O(\NLW_STEP_reg[0]_i_5_O_UNCONNECTED [3:0]),
        .S({\STEP[0]_i_13_n_0 ,\STEP[0]_i_14_n_0 ,\STEP[0]_i_15_n_0 ,\STEP[0]_i_16_n_0 }));
  FDRE \STEP_reg[1] 
       (.C(CLK),
        .CE(1'b1),
        .D(\STEP[1]_i_1_n_0 ),
        .Q(STEP_s[1]),
        .R(1'b0));
  (* COMPARATOR_THRESHOLD = "11" *) 
  CARRY4 \STEP_reg[1]_i_16 
       (.CI(\STEP_reg[1]_i_29_n_0 ),
        .CO({\STEP_reg[1]_i_16_n_0 ,\STEP_reg[1]_i_16_n_1 ,\STEP_reg[1]_i_16_n_2 ,\STEP_reg[1]_i_16_n_3 }),
        .CYINIT(1'b0),
        .DI({1'b0,\STEP[1]_i_30_n_0 ,\STEP[1]_i_31_n_0 ,1'b0}),
        .O(\NLW_STEP_reg[1]_i_16_O_UNCONNECTED [3:0]),
        .S({\STEP[1]_i_32_n_0 ,\STEP[1]_i_33_n_0 ,\STEP[1]_i_34_n_0 ,\STEP[1]_i_35_n_0 }));
  (* COMPARATOR_THRESHOLD = "11" *) 
  CARRY4 \STEP_reg[1]_i_2 
       (.CI(\STEP_reg[1]_i_5_n_0 ),
        .CO({\NLW_STEP_reg[1]_i_2_CO_UNCONNECTED [3:1],ltOp}),
        .CYINIT(1'b0),
        .DI({1'b0,1'b0,1'b0,1'b0}),
        .O(\NLW_STEP_reg[1]_i_2_O_UNCONNECTED [3:0]),
        .S({1'b0,1'b0,1'b0,\STEP[1]_i_6_n_0 }));
  (* COMPARATOR_THRESHOLD = "11" *) 
  CARRY4 \STEP_reg[1]_i_21 
       (.CI(\STEP_reg[1]_i_36_n_0 ),
        .CO({\STEP_reg[1]_i_21_n_0 ,\STEP_reg[1]_i_21_n_1 ,\STEP_reg[1]_i_21_n_2 ,\STEP_reg[1]_i_21_n_3 }),
        .CYINIT(1'b0),
        .DI({\STEP[1]_i_37_n_0 ,counter_reg[13],\STEP[1]_i_38_n_0 ,\STEP[1]_i_39_n_0 }),
        .O(\NLW_STEP_reg[1]_i_21_O_UNCONNECTED [3:0]),
        .S({\STEP[1]_i_40_n_0 ,\STEP[1]_i_41_n_0 ,\STEP[1]_i_42_n_0 ,\STEP[1]_i_43_n_0 }));
  (* COMPARATOR_THRESHOLD = "11" *) 
  CARRY4 \STEP_reg[1]_i_29 
       (.CI(1'b0),
        .CO({\STEP_reg[1]_i_29_n_0 ,\STEP_reg[1]_i_29_n_1 ,\STEP_reg[1]_i_29_n_2 ,\STEP_reg[1]_i_29_n_3 }),
        .CYINIT(1'b0),
        .DI({\STEP[1]_i_44_n_0 ,\STEP[1]_i_45_n_0 ,\STEP[1]_i_46_n_0 ,\STEP[1]_i_47_n_0 }),
        .O(\NLW_STEP_reg[1]_i_29_O_UNCONNECTED [3:0]),
        .S({\STEP[1]_i_48_n_0 ,\STEP[1]_i_49_n_0 ,\STEP[1]_i_50_n_0 ,\STEP[1]_i_51_n_0 }));
  (* COMPARATOR_THRESHOLD = "11" *) 
  CARRY4 \STEP_reg[1]_i_3 
       (.CI(\STEP_reg[1]_i_7_n_0 ),
        .CO({geqOp2_in,\STEP_reg[1]_i_3_n_1 ,\STEP_reg[1]_i_3_n_2 ,\STEP_reg[1]_i_3_n_3 }),
        .CYINIT(1'b0),
        .DI({\STEP[1]_i_8_n_0 ,\STEP[1]_i_9_n_0 ,\STEP[1]_i_10_n_0 ,\STEP[1]_i_11_n_0 }),
        .O(\NLW_STEP_reg[1]_i_3_O_UNCONNECTED [3:0]),
        .S({\STEP[1]_i_12_n_0 ,\STEP[1]_i_13_n_0 ,\STEP[1]_i_14_n_0 ,\STEP[1]_i_15_n_0 }));
  (* COMPARATOR_THRESHOLD = "11" *) 
  CARRY4 \STEP_reg[1]_i_36 
       (.CI(1'b0),
        .CO({\STEP_reg[1]_i_36_n_0 ,\STEP_reg[1]_i_36_n_1 ,\STEP_reg[1]_i_36_n_2 ,\STEP_reg[1]_i_36_n_3 }),
        .CYINIT(1'b1),
        .DI({\STEP[1]_i_52_n_0 ,\STEP[1]_i_53_n_0 ,\STEP[1]_i_54_n_0 ,\STEP[1]_i_55_n_0 }),
        .O(\NLW_STEP_reg[1]_i_36_O_UNCONNECTED [3:0]),
        .S({\STEP[1]_i_56_n_0 ,\STEP[1]_i_57_n_0 ,\STEP[1]_i_58_n_0 ,\STEP[1]_i_59_n_0 }));
  (* COMPARATOR_THRESHOLD = "11" *) 
  CARRY4 \STEP_reg[1]_i_5 
       (.CI(\STEP_reg[1]_i_16_n_0 ),
        .CO({\STEP_reg[1]_i_5_n_0 ,\STEP_reg[1]_i_5_n_1 ,\STEP_reg[1]_i_5_n_2 ,\STEP_reg[1]_i_5_n_3 }),
        .CYINIT(1'b0),
        .DI({1'b0,1'b0,1'b0,1'b0}),
        .O(\NLW_STEP_reg[1]_i_5_O_UNCONNECTED [3:0]),
        .S({\STEP[1]_i_17_n_0 ,\STEP[1]_i_18_n_0 ,\STEP[1]_i_19_n_0 ,\STEP[1]_i_20_n_0 }));
  (* COMPARATOR_THRESHOLD = "11" *) 
  CARRY4 \STEP_reg[1]_i_7 
       (.CI(\STEP_reg[1]_i_21_n_0 ),
        .CO({\STEP_reg[1]_i_7_n_0 ,\STEP_reg[1]_i_7_n_1 ,\STEP_reg[1]_i_7_n_2 ,\STEP_reg[1]_i_7_n_3 }),
        .CYINIT(1'b0),
        .DI({\STEP[1]_i_22_n_0 ,\STEP[1]_i_23_n_0 ,counter_reg[19],\STEP[1]_i_24_n_0 }),
        .O(\NLW_STEP_reg[1]_i_7_O_UNCONNECTED [3:0]),
        .S({\STEP[1]_i_25_n_0 ,\STEP[1]_i_26_n_0 ,\STEP[1]_i_27_n_0 ,\STEP[1]_i_28_n_0 }));
  LUT6 #(
    .INIT(64'hFFFFFFFF0F335500)) 
    \Segment[0]_INST_0 
       (.I0(Segment_0_sn_1),
        .I1(\Segment[0]_0 ),
        .I2(\Segment[0]_1 ),
        .I3(STEP_s[1]),
        .I4(STEP_s[0]),
        .I5(\Segment[3]_INST_0_i_4_n_0 ),
        .O(Segment[0]));
  (* SOFT_HLUTNM = "soft_lutpair32" *) 
  LUT2 #(
    .INIT(4'h8)) 
    \Segment[1]_INST_0_i_2 
       (.I0(STEP_s[1]),
        .I1(STEP_s[0]),
        .O(\STEP_reg[1]_2 ));
  LUT6 #(
    .INIT(64'h02200000AAAAAAAA)) 
    \Segment[1]_INST_0_i_5 
       (.I0(\Segment[4]_INST_0_i_7_n_0 ),
        .I1(Digit12_out[3]),
        .I2(Digit12_out[1]),
        .I3(Digit12_out[0]),
        .I4(Digit12_out[2]),
        .I5(Segment_1_sn_1),
        .O(\STEP_reg[0]_0 ));
  (* SOFT_HLUTNM = "soft_lutpair33" *) 
  LUT2 #(
    .INIT(4'h2)) 
    \Segment[1]_INST_0_i_6 
       (.I0(STEP_s[1]),
        .I1(STEP_s[0]),
        .O(\STEP_reg[1]_3 ));
  LUT6 #(
    .INIT(64'h0000004044444444)) 
    \Segment[2]_INST_0_i_2 
       (.I0(STEP_s[1]),
        .I1(STEP_s[0]),
        .I2(Digit12_out[1]),
        .I3(Digit12_out[0]),
        .I4(Digit12_out[2]),
        .I5(Segment_1_sn_1),
        .O(\STEP_reg[1]_0 ));
  LUT6 #(
    .INIT(64'hFFFFFFFF33550F00)) 
    \Segment[3]_INST_0 
       (.I0(\Segment[3] ),
        .I1(\Segment[3]_0 ),
        .I2(\Segment[3]_1 ),
        .I3(STEP_s[0]),
        .I4(STEP_s[1]),
        .I5(\Segment[3]_INST_0_i_4_n_0 ),
        .O(Segment[1]));
  LUT6 #(
    .INIT(64'h0011000011100001)) 
    \Segment[3]_INST_0_i_4 
       (.I0(STEP_s[0]),
        .I1(STEP_s[1]),
        .I2(\Segment[6]_2 ),
        .I3(CO),
        .I4(Q[0]),
        .I5(Q[1]),
        .O(\Segment[3]_INST_0_i_4_n_0 ));
  LUT6 #(
    .INIT(64'hAAA888A8AAAAAAAA)) 
    \Segment[4]_INST_0_i_2 
       (.I0(\Segment[4]_INST_0_i_7_n_0 ),
        .I1(Digit12_out[0]),
        .I2(Digit12_out[2]),
        .I3(Digit12_out[1]),
        .I4(Digit12_out[3]),
        .I5(\Segment[4] ),
        .O(\STEP_reg[0]_1 ));
  (* SOFT_HLUTNM = "soft_lutpair31" *) 
  LUT2 #(
    .INIT(4'h1)) 
    \Segment[4]_INST_0_i_4 
       (.I0(STEP_s[1]),
        .I1(STEP_s[0]),
        .O(\STEP_reg[1]_1 ));
  (* SOFT_HLUTNM = "soft_lutpair30" *) 
  LUT2 #(
    .INIT(4'h2)) 
    \Segment[4]_INST_0_i_7 
       (.I0(STEP_s[0]),
        .I1(STEP_s[1]),
        .O(\Segment[4]_INST_0_i_7_n_0 ));
  LUT6 #(
    .INIT(64'hFEFCFECCCEFCCECC)) 
    \Segment[6]_INST_0 
       (.I0(\Segment[6] ),
        .I1(\Segment[6]_INST_0_i_2_n_0 ),
        .I2(STEP_s[0]),
        .I3(STEP_s[1]),
        .I4(\Segment[6]_0 ),
        .I5(\Segment[6]_1 ),
        .O(Segment[2]));
  LUT6 #(
    .INIT(64'h0000111100001101)) 
    \Segment[6]_INST_0_i_2 
       (.I0(STEP_s[0]),
        .I1(STEP_s[1]),
        .I2(Q[0]),
        .I3(\Segment[6]_2 ),
        .I4(Q[1]),
        .I5(CO),
        .O(\Segment[6]_INST_0_i_2_n_0 ));
  LUT4 #(
    .INIT(16'h0015)) 
    \counter[0]_i_1 
       (.I0(\STEP[1]_i_4_n_0 ),
        .I1(geqOp2_in),
        .I2(ltOp3_in),
        .I3(ltOp),
        .O(counter));
  LUT1 #(
    .INIT(2'h1)) 
    \counter[0]_i_3 
       (.I0(counter_reg[0]),
        .O(\counter[0]_i_3_n_0 ));
  FDRE #(
    .INIT(1'b0)) 
    \counter_reg[0] 
       (.C(CLK),
        .CE(1'b1),
        .D(\counter_reg[0]_i_2_n_7 ),
        .Q(counter_reg[0]),
        .R(counter));
  (* ADDER_THRESHOLD = "11" *) 
  CARRY4 \counter_reg[0]_i_2 
       (.CI(1'b0),
        .CO({\counter_reg[0]_i_2_n_0 ,\counter_reg[0]_i_2_n_1 ,\counter_reg[0]_i_2_n_2 ,\counter_reg[0]_i_2_n_3 }),
        .CYINIT(1'b0),
        .DI({1'b0,1'b0,1'b0,1'b1}),
        .O({\counter_reg[0]_i_2_n_4 ,\counter_reg[0]_i_2_n_5 ,\counter_reg[0]_i_2_n_6 ,\counter_reg[0]_i_2_n_7 }),
        .S({counter_reg[3:1],\counter[0]_i_3_n_0 }));
  FDRE #(
    .INIT(1'b0)) 
    \counter_reg[10] 
       (.C(CLK),
        .CE(1'b1),
        .D(\counter_reg[8]_i_1_n_5 ),
        .Q(counter_reg[10]),
        .R(counter));
  FDRE #(
    .INIT(1'b0)) 
    \counter_reg[11] 
       (.C(CLK),
        .CE(1'b1),
        .D(\counter_reg[8]_i_1_n_4 ),
        .Q(counter_reg[11]),
        .R(counter));
  FDRE #(
    .INIT(1'b0)) 
    \counter_reg[12] 
       (.C(CLK),
        .CE(1'b1),
        .D(\counter_reg[12]_i_1_n_7 ),
        .Q(counter_reg[12]),
        .R(counter));
  (* ADDER_THRESHOLD = "11" *) 
  CARRY4 \counter_reg[12]_i_1 
       (.CI(\counter_reg[8]_i_1_n_0 ),
        .CO({\counter_reg[12]_i_1_n_0 ,\counter_reg[12]_i_1_n_1 ,\counter_reg[12]_i_1_n_2 ,\counter_reg[12]_i_1_n_3 }),
        .CYINIT(1'b0),
        .DI({1'b0,1'b0,1'b0,1'b0}),
        .O({\counter_reg[12]_i_1_n_4 ,\counter_reg[12]_i_1_n_5 ,\counter_reg[12]_i_1_n_6 ,\counter_reg[12]_i_1_n_7 }),
        .S(counter_reg[15:12]));
  FDRE #(
    .INIT(1'b0)) 
    \counter_reg[13] 
       (.C(CLK),
        .CE(1'b1),
        .D(\counter_reg[12]_i_1_n_6 ),
        .Q(counter_reg[13]),
        .R(counter));
  FDRE #(
    .INIT(1'b0)) 
    \counter_reg[14] 
       (.C(CLK),
        .CE(1'b1),
        .D(\counter_reg[12]_i_1_n_5 ),
        .Q(counter_reg[14]),
        .R(counter));
  FDRE #(
    .INIT(1'b0)) 
    \counter_reg[15] 
       (.C(CLK),
        .CE(1'b1),
        .D(\counter_reg[12]_i_1_n_4 ),
        .Q(counter_reg[15]),
        .R(counter));
  FDRE #(
    .INIT(1'b0)) 
    \counter_reg[16] 
       (.C(CLK),
        .CE(1'b1),
        .D(\counter_reg[16]_i_1_n_7 ),
        .Q(counter_reg[16]),
        .R(counter));
  (* ADDER_THRESHOLD = "11" *) 
  CARRY4 \counter_reg[16]_i_1 
       (.CI(\counter_reg[12]_i_1_n_0 ),
        .CO({\counter_reg[16]_i_1_n_0 ,\counter_reg[16]_i_1_n_1 ,\counter_reg[16]_i_1_n_2 ,\counter_reg[16]_i_1_n_3 }),
        .CYINIT(1'b0),
        .DI({1'b0,1'b0,1'b0,1'b0}),
        .O({\counter_reg[16]_i_1_n_4 ,\counter_reg[16]_i_1_n_5 ,\counter_reg[16]_i_1_n_6 ,\counter_reg[16]_i_1_n_7 }),
        .S(counter_reg[19:16]));
  FDRE #(
    .INIT(1'b0)) 
    \counter_reg[17] 
       (.C(CLK),
        .CE(1'b1),
        .D(\counter_reg[16]_i_1_n_6 ),
        .Q(counter_reg[17]),
        .R(counter));
  FDRE #(
    .INIT(1'b0)) 
    \counter_reg[18] 
       (.C(CLK),
        .CE(1'b1),
        .D(\counter_reg[16]_i_1_n_5 ),
        .Q(counter_reg[18]),
        .R(counter));
  FDRE #(
    .INIT(1'b0)) 
    \counter_reg[19] 
       (.C(CLK),
        .CE(1'b1),
        .D(\counter_reg[16]_i_1_n_4 ),
        .Q(counter_reg[19]),
        .R(counter));
  FDRE #(
    .INIT(1'b0)) 
    \counter_reg[1] 
       (.C(CLK),
        .CE(1'b1),
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
        .CYINIT(1'b0),
        .DI({1'b0,1'b0,1'b0,1'b0}),
        .O({\counter_reg[4]_i_1_n_4 ,\counter_reg[4]_i_1_n_5 ,\counter_reg[4]_i_1_n_6 ,\counter_reg[4]_i_1_n_7 }),
        .S(counter_reg[7:4]));
  FDRE #(
    .INIT(1'b0)) 
    \counter_reg[5] 
       (.C(CLK),
        .CE(1'b1),
        .D(\counter_reg[4]_i_1_n_6 ),
        .Q(counter_reg[5]),
        .R(counter));
  FDRE #(
    .INIT(1'b0)) 
    \counter_reg[6] 
       (.C(CLK),
        .CE(1'b1),
        .D(\counter_reg[4]_i_1_n_5 ),
        .Q(counter_reg[6]),
        .R(counter));
  FDRE #(
    .INIT(1'b0)) 
    \counter_reg[7] 
       (.C(CLK),
        .CE(1'b1),
        .D(\counter_reg[4]_i_1_n_4 ),
        .Q(counter_reg[7]),
        .R(counter));
  FDRE #(
    .INIT(1'b0)) 
    \counter_reg[8] 
       (.C(CLK),
        .CE(1'b1),
        .D(\counter_reg[8]_i_1_n_7 ),
        .Q(counter_reg[8]),
        .R(counter));
  (* ADDER_THRESHOLD = "11" *) 
  CARRY4 \counter_reg[8]_i_1 
       (.CI(\counter_reg[4]_i_1_n_0 ),
        .CO({\counter_reg[8]_i_1_n_0 ,\counter_reg[8]_i_1_n_1 ,\counter_reg[8]_i_1_n_2 ,\counter_reg[8]_i_1_n_3 }),
        .CYINIT(1'b0),
        .DI({1'b0,1'b0,1'b0,1'b0}),
        .O({\counter_reg[8]_i_1_n_4 ,\counter_reg[8]_i_1_n_5 ,\counter_reg[8]_i_1_n_6 ,\counter_reg[8]_i_1_n_7 }),
        .S(counter_reg[11:8]));
  FDRE #(
    .INIT(1'b0)) 
    \counter_reg[9] 
       (.C(CLK),
        .CE(1'b1),
        .D(\counter_reg[8]_i_1_n_6 ),
        .Q(counter_reg[9]),
        .R(counter));
  (* COMPARATOR_THRESHOLD = "11" *) 
  CARRY4 geqOp_carry
       (.CI(1'b0),
        .CO({geqOp_carry_n_0,geqOp_carry_n_1,geqOp_carry_n_2,geqOp_carry_n_3}),
        .CYINIT(1'b1),
        .DI({geqOp_carry_i_1_n_0,geqOp_carry_i_2_n_0,geqOp_carry_i_3_n_0,geqOp_carry_i_4_n_0}),
        .O(NLW_geqOp_carry_O_UNCONNECTED[3:0]),
        .S({geqOp_carry_i_5_n_0,geqOp_carry_i_6_n_0,geqOp_carry_i_7_n_0,geqOp_carry_i_8_n_0}));
  (* COMPARATOR_THRESHOLD = "11" *) 
  CARRY4 geqOp_carry__0
       (.CI(geqOp_carry_n_0),
        .CO({geqOp_carry__0_n_0,geqOp_carry__0_n_1,geqOp_carry__0_n_2,geqOp_carry__0_n_3}),
        .CYINIT(1'b0),
        .DI({counter_reg[15],geqOp_carry__0_i_1_n_0,1'b0,1'b0}),
        .O(NLW_geqOp_carry__0_O_UNCONNECTED[3:0]),
        .S({geqOp_carry__0_i_2_n_0,geqOp_carry__0_i_3_n_0,geqOp_carry__0_i_4_n_0,geqOp_carry__0_i_5_n_0}));
  LUT2 #(
    .INIT(4'hE)) 
    geqOp_carry__0_i_1
       (.I0(counter_reg[12]),
        .I1(counter_reg[13]),
        .O(geqOp_carry__0_i_1_n_0));
  LUT2 #(
    .INIT(4'h2)) 
    geqOp_carry__0_i_2
       (.I0(counter_reg[14]),
        .I1(counter_reg[15]),
        .O(geqOp_carry__0_i_2_n_0));
  LUT2 #(
    .INIT(4'h1)) 
    geqOp_carry__0_i_3
       (.I0(counter_reg[13]),
        .I1(counter_reg[12]),
        .O(geqOp_carry__0_i_3_n_0));
  LUT2 #(
    .INIT(4'h8)) 
    geqOp_carry__0_i_4
       (.I0(counter_reg[11]),
        .I1(counter_reg[10]),
        .O(geqOp_carry__0_i_4_n_0));
  LUT2 #(
    .INIT(4'h8)) 
    geqOp_carry__0_i_5
       (.I0(counter_reg[9]),
        .I1(counter_reg[8]),
        .O(geqOp_carry__0_i_5_n_0));
  (* COMPARATOR_THRESHOLD = "11" *) 
  CARRY4 geqOp_carry__1
       (.CI(geqOp_carry__0_n_0),
        .CO({geqOp_carry__1_n_0,geqOp_carry__1_n_1,geqOp_carry__1_n_2,geqOp_carry__1_n_3}),
        .CYINIT(1'b0),
        .DI({geqOp_carry__1_i_1_n_0,counter_reg[21],geqOp_carry__1_i_2_n_0,geqOp_carry__1_i_3_n_0}),
        .O(NLW_geqOp_carry__1_O_UNCONNECTED[3:0]),
        .S({geqOp_carry__1_i_4_n_0,geqOp_carry__1_i_5_n_0,geqOp_carry__1_i_6_n_0,geqOp_carry__1_i_7_n_0}));
  LUT2 #(
    .INIT(4'hE)) 
    geqOp_carry__1_i_1
       (.I0(counter_reg[22]),
        .I1(counter_reg[23]),
        .O(geqOp_carry__1_i_1_n_0));
  LUT2 #(
    .INIT(4'hE)) 
    geqOp_carry__1_i_2
       (.I0(counter_reg[18]),
        .I1(counter_reg[19]),
        .O(geqOp_carry__1_i_2_n_0));
  LUT2 #(
    .INIT(4'h8)) 
    geqOp_carry__1_i_3
       (.I0(counter_reg[16]),
        .I1(counter_reg[17]),
        .O(geqOp_carry__1_i_3_n_0));
  LUT2 #(
    .INIT(4'h1)) 
    geqOp_carry__1_i_4
       (.I0(counter_reg[23]),
        .I1(counter_reg[22]),
        .O(geqOp_carry__1_i_4_n_0));
  LUT2 #(
    .INIT(4'h2)) 
    geqOp_carry__1_i_5
       (.I0(counter_reg[20]),
        .I1(counter_reg[21]),
        .O(geqOp_carry__1_i_5_n_0));
  LUT2 #(
    .INIT(4'h1)) 
    geqOp_carry__1_i_6
       (.I0(counter_reg[19]),
        .I1(counter_reg[18]),
        .O(geqOp_carry__1_i_6_n_0));
  LUT2 #(
    .INIT(4'h2)) 
    geqOp_carry__1_i_7
       (.I0(counter_reg[17]),
        .I1(counter_reg[16]),
        .O(geqOp_carry__1_i_7_n_0));
  (* COMPARATOR_THRESHOLD = "11" *) 
  CARRY4 geqOp_carry__2
       (.CI(geqOp_carry__1_n_0),
        .CO({geqOp,geqOp_carry__2_n_1,geqOp_carry__2_n_2,geqOp_carry__2_n_3}),
        .CYINIT(1'b0),
        .DI({geqOp_carry__2_i_1_n_0,geqOp_carry__2_i_2_n_0,geqOp_carry__2_i_3_n_0,geqOp_carry__2_i_4_n_0}),
        .O(NLW_geqOp_carry__2_O_UNCONNECTED[3:0]),
        .S({geqOp_carry__2_i_5_n_0,geqOp_carry__2_i_6_n_0,geqOp_carry__2_i_7_n_0,geqOp_carry__2_i_8_n_0}));
  LUT2 #(
    .INIT(4'hE)) 
    geqOp_carry__2_i_1
       (.I0(counter_reg[30]),
        .I1(counter_reg[31]),
        .O(geqOp_carry__2_i_1_n_0));
  LUT2 #(
    .INIT(4'hE)) 
    geqOp_carry__2_i_2
       (.I0(counter_reg[28]),
        .I1(counter_reg[29]),
        .O(geqOp_carry__2_i_2_n_0));
  LUT2 #(
    .INIT(4'hE)) 
    geqOp_carry__2_i_3
       (.I0(counter_reg[26]),
        .I1(counter_reg[27]),
        .O(geqOp_carry__2_i_3_n_0));
  LUT2 #(
    .INIT(4'hE)) 
    geqOp_carry__2_i_4
       (.I0(counter_reg[24]),
        .I1(counter_reg[25]),
        .O(geqOp_carry__2_i_4_n_0));
  LUT2 #(
    .INIT(4'h1)) 
    geqOp_carry__2_i_5
       (.I0(counter_reg[31]),
        .I1(counter_reg[30]),
        .O(geqOp_carry__2_i_5_n_0));
  LUT2 #(
    .INIT(4'h1)) 
    geqOp_carry__2_i_6
       (.I0(counter_reg[29]),
        .I1(counter_reg[28]),
        .O(geqOp_carry__2_i_6_n_0));
  LUT2 #(
    .INIT(4'h1)) 
    geqOp_carry__2_i_7
       (.I0(counter_reg[27]),
        .I1(counter_reg[26]),
        .O(geqOp_carry__2_i_7_n_0));
  LUT2 #(
    .INIT(4'h1)) 
    geqOp_carry__2_i_8
       (.I0(counter_reg[25]),
        .I1(counter_reg[24]),
        .O(geqOp_carry__2_i_8_n_0));
  LUT2 #(
    .INIT(4'h8)) 
    geqOp_carry_i_1
       (.I0(counter_reg[6]),
        .I1(counter_reg[7]),
        .O(geqOp_carry_i_1_n_0));
  LUT2 #(
    .INIT(4'hE)) 
    geqOp_carry_i_2
       (.I0(counter_reg[4]),
        .I1(counter_reg[5]),
        .O(geqOp_carry_i_2_n_0));
  LUT2 #(
    .INIT(4'hE)) 
    geqOp_carry_i_3
       (.I0(counter_reg[2]),
        .I1(counter_reg[3]),
        .O(geqOp_carry_i_3_n_0));
  LUT2 #(
    .INIT(4'hE)) 
    geqOp_carry_i_4
       (.I0(counter_reg[0]),
        .I1(counter_reg[1]),
        .O(geqOp_carry_i_4_n_0));
  LUT2 #(
    .INIT(4'h2)) 
    geqOp_carry_i_5
       (.I0(counter_reg[7]),
        .I1(counter_reg[6]),
        .O(geqOp_carry_i_5_n_0));
  LUT2 #(
    .INIT(4'h1)) 
    geqOp_carry_i_6
       (.I0(counter_reg[5]),
        .I1(counter_reg[4]),
        .O(geqOp_carry_i_6_n_0));
  LUT2 #(
    .INIT(4'h1)) 
    geqOp_carry_i_7
       (.I0(counter_reg[3]),
        .I1(counter_reg[2]),
        .O(geqOp_carry_i_7_n_0));
  LUT2 #(
    .INIT(4'h1)) 
    geqOp_carry_i_8
       (.I0(counter_reg[1]),
        .I1(counter_reg[0]),
        .O(geqOp_carry_i_8_n_0));
  (* COMPARATOR_THRESHOLD = "11" *) 
  CARRY4 \geqOp_inferred__1/i__carry 
       (.CI(1'b0),
        .CO({\geqOp_inferred__1/i__carry_n_0 ,\geqOp_inferred__1/i__carry_n_1 ,\geqOp_inferred__1/i__carry_n_2 ,\geqOp_inferred__1/i__carry_n_3 }),
        .CYINIT(1'b1),
        .DI({i__carry_i_1__3_n_0,i__carry_i_2__3_n_0,i__carry_i_3__3_n_0,i__carry_i_4__2_n_0}),
        .O(\NLW_geqOp_inferred__1/i__carry_O_UNCONNECTED [3:0]),
        .S({i__carry_i_5__2_n_0,i__carry_i_6__2_n_0,i__carry_i_7__2_n_0,i__carry_i_8__0_n_0}));
  (* COMPARATOR_THRESHOLD = "11" *) 
  CARRY4 \geqOp_inferred__1/i__carry__0 
       (.CI(\geqOp_inferred__1/i__carry_n_0 ),
        .CO({\geqOp_inferred__1/i__carry__0_n_0 ,\geqOp_inferred__1/i__carry__0_n_1 ,\geqOp_inferred__1/i__carry__0_n_2 ,\geqOp_inferred__1/i__carry__0_n_3 }),
        .CYINIT(1'b0),
        .DI({i__carry__0_i_1__2_n_0,1'b0,counter_reg[11],counter_reg[9]}),
        .O(\NLW_geqOp_inferred__1/i__carry__0_O_UNCONNECTED [3:0]),
        .S({i__carry__0_i_2__2_n_0,i__carry__0_i_3__1_n_0,i__carry__0_i_4__1_n_0,i__carry__0_i_5__1_n_0}));
  (* COMPARATOR_THRESHOLD = "11" *) 
  CARRY4 \geqOp_inferred__1/i__carry__1 
       (.CI(\geqOp_inferred__1/i__carry__0_n_0 ),
        .CO({\geqOp_inferred__1/i__carry__1_n_0 ,\geqOp_inferred__1/i__carry__1_n_1 ,\geqOp_inferred__1/i__carry__1_n_2 ,\geqOp_inferred__1/i__carry__1_n_3 }),
        .CYINIT(1'b0),
        .DI({i__carry__1_i_1__0_n_0,i__carry__1_i_2__0_n_0,1'b0,i__carry__1_i_3__0_n_0}),
        .O(\NLW_geqOp_inferred__1/i__carry__1_O_UNCONNECTED [3:0]),
        .S({i__carry__1_i_4__0_n_0,i__carry__1_i_5__0_n_0,i__carry__1_i_6__0_n_0,i__carry__1_i_7__0_n_0}));
  (* COMPARATOR_THRESHOLD = "11" *) 
  CARRY4 \geqOp_inferred__1/i__carry__2 
       (.CI(\geqOp_inferred__1/i__carry__1_n_0 ),
        .CO({geqOp1_in,\geqOp_inferred__1/i__carry__2_n_1 ,\geqOp_inferred__1/i__carry__2_n_2 ,\geqOp_inferred__1/i__carry__2_n_3 }),
        .CYINIT(1'b0),
        .DI({i__carry__2_i_1__0_n_0,i__carry__2_i_2__0_n_0,i__carry__2_i_3__0_n_0,i__carry__2_i_4__0_n_0}),
        .O(\NLW_geqOp_inferred__1/i__carry__2_O_UNCONNECTED [3:0]),
        .S({i__carry__2_i_5_n_0,i__carry__2_i_6__0_n_0,i__carry__2_i_7__0_n_0,i__carry__2_i_8__0_n_0}));
  LUT2 #(
    .INIT(4'h7)) 
    i__carry__0_i_1__1
       (.I0(counter_reg[18]),
        .I1(counter_reg[19]),
        .O(i__carry__0_i_1__1_n_0));
  LUT2 #(
    .INIT(4'hE)) 
    i__carry__0_i_1__2
       (.I0(counter_reg[14]),
        .I1(counter_reg[15]),
        .O(i__carry__0_i_1__2_n_0));
  LUT2 #(
    .INIT(4'h1)) 
    i__carry__0_i_1__3
       (.I0(counter_reg[21]),
        .I1(counter_reg[20]),
        .O(i__carry__0_i_1__3_n_0));
  LUT1 #(
    .INIT(2'h1)) 
    i__carry__0_i_2__1
       (.I0(counter_reg[17]),
        .O(i__carry__0_i_2__1_n_0));
  LUT2 #(
    .INIT(4'h1)) 
    i__carry__0_i_2__2
       (.I0(counter_reg[15]),
        .I1(counter_reg[14]),
        .O(i__carry__0_i_2__2_n_0));
  LUT2 #(
    .INIT(4'h1)) 
    i__carry__0_i_2__3
       (.I0(counter_reg[23]),
        .I1(counter_reg[22]),
        .O(i__carry__0_i_2__3_n_0));
  LUT2 #(
    .INIT(4'h8)) 
    i__carry__0_i_3__1
       (.I0(counter_reg[13]),
        .I1(counter_reg[12]),
        .O(i__carry__0_i_3__1_n_0));
  LUT2 #(
    .INIT(4'h1)) 
    i__carry__0_i_3__2
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
        .O(i__carry_i_6__1_n_0));
  LUT2 #(
    .INIT(4'h1)) 
    i__carry_i_6__2
       (.I0(counter_reg[5]),
        .I1(counter_reg[4]),
        .O(i__carry_i_6__2_n_0));
  LUT2 #(
    .INIT(4'h2)) 
    i__carry_i_6__3
       (.I0(counter_reg[10]),
        .I1(counter_reg[11]),
        .O(i__carry_i_6__3_n_0));
  LUT2 #(
    .INIT(4'h2)) 
    i__carry_i_7__1
       (.I0(counter_reg[7]),
        .I1(counter_reg[6]),
        .O(i__carry_i_7__1_n_0));
  LUT2 #(
    .INIT(4'h1)) 
    i__carry_i_7__2
       (.I0(counter_reg[3]),
        .I1(counter_reg[2]),
        .O(i__carry_i_7__2_n_0));
  LUT2 #(
    .INIT(4'h2)) 
    i__carry_i_7__3
       (.I0(counter_reg[8]),
        .I1(counter_reg[9]),
        .O(i__carry_i_7__3_n_0));
  LUT2 #(
    .INIT(4'h1)) 
    i__carry_i_8__0
       (.I0(counter_reg[1]),
        .I1(counter_reg[0]),
        .O(i__carry_i_8__0_n_0));
  (* COMPARATOR_THRESHOLD = "11" *) 
  CARRY4 \ltOp_inferred__0/i__carry 
       (.CI(1'b0),
        .CO({\ltOp_inferred__0/i__carry_n_0 ,\ltOp_inferred__0/i__carry_n_1 ,\ltOp_inferred__0/i__carry_n_2 ,\ltOp_inferred__0/i__carry_n_3 }),
        .CYINIT(1'b0),
        .DI({1'b0,i__carry_i_1__1_n_0,i__carry_i_2__1_n_0,i__carry_i_3__1_n_0}),
        .O(\NLW_ltOp_inferred__0/i__carry_O_UNCONNECTED [3:0]),
        .S({i__carry_i_4__3_n_0,i__carry_i_5__3_n_0,i__carry_i_6__3_n_0,i__carry_i_7__3_n_0}));
  (* COMPARATOR_THRESHOLD = "11" *) 
  CARRY4 \ltOp_inferred__0/i__carry__0 
       (.CI(\ltOp_inferred__0/i__carry_n_0 ),
        .CO({\ltOp_inferred__0/i__carry__0_n_0 ,\ltOp_inferred__0/i__carry__0_n_1 ,\ltOp_inferred__0/i__carry__0_n_2 ,\ltOp_inferred__0/i__carry__0_n_3 }),
        .CYINIT(1'b0),
        .DI({1'b0,1'b0,i__carry__0_i_1__1_n_0,1'b0}),
        .O(\NLW_ltOp_inferred__0/i__carry__0_O_UNCONNECTED [3:0]),
        .S({i__carry__0_i_2__3_n_0,i__carry__0_i_3__2_n_0,i__carry__0_i_4__2_n_0,i__carry__0_i_5__2_n_0}));
  (* COMPARATOR_THRESHOLD = "11" *) 
  CARRY4 \ltOp_inferred__0/i__carry__1 
       (.CI(\ltOp_inferred__0/i__carry__0_n_0 ),
        .CO({ltOp3_in,\ltOp_inferred__0/i__carry__1_n_1 ,\ltOp_inferred__0/i__carry__1_n_2 ,\ltOp_inferred__0/i__carry__1_n_3 }),
        .CYINIT(1'b0),
        .DI({1'b0,1'b0,1'b0,1'b0}),
        .O(\NLW_ltOp_inferred__0/i__carry__1_O_UNCONNECTED [3:0]),
        .S({i__carry__1_i_1__1_n_0,i__carry__1_i_2__1_n_0,i__carry__1_i_3__1_n_0,i__carry__1_i_4__1_n_0}));
  (* COMPARATOR_THRESHOLD = "11" *) 
  CARRY4 \ltOp_inferred__2/i__carry 
       (.CI(1'b0),
        .CO({\ltOp_inferred__2/i__carry_n_0 ,\ltOp_inferred__2/i__carry_n_1 ,\ltOp_inferred__2/i__carry_n_2 ,\ltOp_inferred__2/i__carry_n_3 }),
        .CYINIT(1'b0),
        .DI({1'b0,i__carry_i_1__2_n_0,i__carry_i_2__2_n_0,i__carry_i_3__2_n_0}),
        .O(\NLW_ltOp_inferred__2/i__carry_O_UNCONNECTED [3:0]),
        .S({i__carry_i_4__1_n_0,i__carry_i_5__1_n_0,i__carry_i_6__1_n_0,i__carry_i_7__1_n_0}));
  (* COMPARATOR_THRESHOLD = "11" *) 
  CARRY4 \ltOp_inferred__2/i__carry__0 
       (.CI(\ltOp_inferred__2/i__carry_n_0 ),
        .CO({\ltOp_inferred__2/i__carry__0_n_0 ,\ltOp_inferred__2/i__carry__0_n_1 ,\ltOp_inferred__2/i__carry__0_n_2 ,\ltOp_inferred__2/i__carry__0_n_3 }),
        .CYINIT(1'b0),
        .DI({i__carry__0_i_1__3_n_0,1'b0,i__carry__0_i_2__1_n_0,i__carry__0_i_3__3_n_0}),
        .O(\NLW_ltOp_inferred__2/i__carry__0_O_UNCONNECTED [3:0]),
        .S({i__carry__0_i_4__0_n_0,i__carry__0_i_5__0_n_0,i__carry__0_i_6__0_n_0,i__carry__0_i_7__0_n_0}));
  (* COMPARATOR_THRESHOLD = "11" *) 
  CARRY4 \ltOp_inferred__2/i__carry__1 
       (.CI(\ltOp_inferred__2/i__carry__0_n_0 ),
        .CO({\ltOp_inferred__2/i__carry__1_n_0 ,\ltOp_inferred__2/i__carry__1_n_1 ,\ltOp_inferred__2/i__carry__1_n_2 ,\ltOp_inferred__2/i__carry__1_n_3 }),
        .CYINIT(1'b0),
        .DI({1'b0,1'b0,1'b0,1'b0}),
        .O(\NLW_ltOp_inferred__2/i__carry__1_O_UNCONNECTED [3:0]),
        .S({i__carry__1_i_1__2_n_0,i__carry__1_i_2__2_n_0,i__carry__1_i_3__2_n_0,i__carry__1_i_4__2_n_0}));
  (* COMPARATOR_THRESHOLD = "11" *) 
  CARRY4 \ltOp_inferred__2/i__carry__2 
       (.CI(\ltOp_inferred__2/i__carry__1_n_0 ),
        .CO({\NLW_ltOp_inferred__2/i__carry__2_CO_UNCONNECTED [3:1],ltOp0_in}),
        .CYINIT(1'b0),
        .DI({1'b0,1'b0,1'b0,1'b0}),
        .O(\NLW_ltOp_inferred__2/i__carry__2_O_UNCONNECTED [3:0]),
        .S({1'b0,1'b0,1'b0,i__carry__2_i_1__1_n_0}));
endmodule

(* COMPLEMENTARIO = "TRUE" *) (* CONTROLADOR = "TRUE" *) (* C_S00_AXI_ADDR_WIDTH = "5" *) 
(* C_S00_AXI_DATA_WIDTH = "32" *) (* Ciclos = "5" *) (* DIRECTO = "FALSE" *) 
(* DeadBand = "4" *) (* Duty_SIZE = "10" *) (* Frecuencia = "1000" *) 
(* KI = "5" *) (* KP = "125" *) (* ORIG_REF_NAME = "Controlador_Motores_BLDC_v1_0" *) 
(* SAMPLES = "40" *) 
module SoCNexys_Controlador_Motores_0_0_Controlador_Motores_BLDC_v1_0
   (CLK,
    RESET,
    A,
    B,
    C,
    A_out,
    B_out,
    C_out,
    PWM_AH,
    PWM_AL,
    PWM_BH,
    PWM_BL,
    PWM_CH,
    PWM_CL,
    PWM_HIGH,
    PWM_LOW,
    ERROR,
    Duty_Led,
    Intc,
    Segment,
    Display,
    s00_axi_aclk,
    s00_axi_aresetn,
    s00_axi_awaddr,
    s00_axi_awprot,
    s00_axi_awvalid,
    s00_axi_awready,
    s00_axi_wdata,
    s00_axi_wstrb,
    s00_axi_wvalid,
    s00_axi_wready,
    s00_axi_bresp,
    s00_axi_bvalid,
    s00_axi_bready,
    s00_axi_araddr,
    s00_axi_arprot,
    s00_axi_arvalid,
    s00_axi_arready,
    s00_axi_rdata,
    s00_axi_rresp,
    s00_axi_rvalid,
    s00_axi_rready);
  input CLK;
  input RESET;
  input A;
  input B;
  input C;
  output A_out;
  output B_out;
  output C_out;
  output PWM_AH;
  output PWM_AL;
  output PWM_BH;
  output PWM_BL;
  output PWM_CH;
  output PWM_CL;
  output PWM_HIGH;
  output PWM_LOW;
  output ERROR;
  output [9:0]Duty_Led;
  output Intc;
  output [6:0]Segment;
  output [3:0]Display;
  input s00_axi_aclk;
  input s00_axi_aresetn;
  input [4:0]s00_axi_awaddr;
  input [2:0]s00_axi_awprot;
  input s00_axi_awvalid;
  output s00_axi_awready;
  input [31:0]s00_axi_wdata;
  input [3:0]s00_axi_wstrb;
  input s00_axi_wvalid;
  output s00_axi_wready;
  output [1:0]s00_axi_bresp;
  output s00_axi_bvalid;
  input s00_axi_bready;
  input [4:0]s00_axi_araddr;
  input [2:0]s00_axi_arprot;
  input s00_axi_arvalid;
  output s00_axi_arready;
  output [31:0]s00_axi_rdata;
  output [1:0]s00_axi_rresp;
  output s00_axi_rvalid;
  input s00_axi_rready;

  wire \<const0> ;
  wire A;
  wire A_out;
  wire B;
  wire B_out;
  wire C;
  wire CLK;
  wire C_out;
  wire [3:0]Display;
  wire [9:0]Duty_Led;
  wire ERROR;
  wire Intc;
  wire PWM_AH;
  wire PWM_AL;
  wire PWM_BH;
  wire PWM_BL;
  wire PWM_CH;
  wire PWM_CL;
  wire PWM_HIGH;
  wire PWM_LOW;
  wire RESET;
  wire [6:0]Segment;
  wire \Segment[0]_INST_0_i_2_n_0 ;
  wire \Segment[3]_INST_0_i_3_n_0 ;
  wire \Segment[4]_INST_0_i_8_n_0 ;
  wire \Segment[5]_INST_0_i_2_n_0 ;
  wire \Segment[6]_INST_0_i_10_n_0 ;
  wire \Segment[6]_INST_0_i_3_n_0 ;
  wire s00_axi_aclk;
  wire [4:0]s00_axi_araddr;
  wire s00_axi_aresetn;
  wire s00_axi_arready;
  wire s00_axi_arvalid;
  wire [4:0]s00_axi_awaddr;
  wire s00_axi_awready;
  wire s00_axi_awvalid;
  wire s00_axi_bready;
  wire s00_axi_bvalid;
  wire [31:0]s00_axi_rdata;
  wire s00_axi_rready;
  wire s00_axi_rvalid;
  wire [31:0]s00_axi_wdata;
  wire s00_axi_wready;
  wire [3:0]s00_axi_wstrb;
  wire s00_axi_wvalid;
  wire [6:0]\uut_Display/Digit12_out ;

  assign s00_axi_bresp[1] = \<const0> ;
  assign s00_axi_bresp[0] = \<const0> ;
  assign s00_axi_rresp[1] = \<const0> ;
  assign s00_axi_rresp[0] = \<const0> ;
  SoCNexys_Controlador_Motores_0_0_Controlador_Motores_BLDC_v1_0_S00_AXI Controlador_Motores_BDLC_v1_0_S00_AXI_inst
       (.A(A),
        .B(B),
        .C(C),
        .CLK(CLK),
        .Digit12_out(\uut_Display/Digit12_out ),
        .Display(Display),
        .ERROR(ERROR),
        .Intc(Intc),
        .OUTPUT_reg(A_out),
        .OUTPUT_reg_0(B_out),
        .OUTPUT_reg_1(C_out),
        .\Output_reg[9] (Duty_Led),
        .PWM_AH(PWM_AH),
        .PWM_AL(PWM_AL),
        .PWM_BH(PWM_BH),
        .PWM_BL(PWM_BL),
        .PWM_CH(PWM_CH),
        .PWM_CL(PWM_CL),
        .Q(PWM_HIGH),
        .RESET(RESET),
        .Segment(Segment),
        .Segment_0_sp_1(\Segment[0]_INST_0_i_2_n_0 ),
        .Segment_1_sp_1(\Segment[6]_INST_0_i_10_n_0 ),
        .Segment_3_sp_1(\Segment[3]_INST_0_i_3_n_0 ),
        .Segment_4_sp_1(\Segment[4]_INST_0_i_8_n_0 ),
        .Segment_5_sp_1(\Segment[5]_INST_0_i_2_n_0 ),
        .Segment_6_sp_1(\Segment[6]_INST_0_i_3_n_0 ),
        .axi_arready_reg_0(s00_axi_arready),
        .axi_awready_reg_0(s00_axi_awready),
        .axi_wready_reg_0(s00_axi_wready),
        .\counter_DelayL_reg[4] (PWM_LOW),
        .s00_axi_aclk(s00_axi_aclk),
        .s00_axi_araddr(s00_axi_araddr[4:2]),
        .s00_axi_aresetn(s00_axi_aresetn),
        .s00_axi_arvalid(s00_axi_arvalid),
        .s00_axi_awaddr(s00_axi_awaddr[4:2]),
        .s00_axi_awvalid(s00_axi_awvalid),
        .s00_axi_bready(s00_axi_bready),
        .s00_axi_bvalid(s00_axi_bvalid),
        .s00_axi_rdata(s00_axi_rdata),
        .s00_axi_rready(s00_axi_rready),
        .s00_axi_rvalid(s00_axi_rvalid),
        .s00_axi_wdata(s00_axi_wdata),
        .s00_axi_wstrb(s00_axi_wstrb),
        .s00_axi_wvalid(s00_axi_wvalid));
  GND GND
       (.G(\<const0> ));
  (* SOFT_HLUTNM = "soft_lutpair41" *) 
  LUT5 #(
    .INIT(32'hAAA8A8AA)) 
    \Segment[0]_INST_0_i_2 
       (.I0(\Segment[6]_INST_0_i_10_n_0 ),
        .I1(\uut_Display/Digit12_out [1]),
        .I2(\uut_Display/Digit12_out [3]),
        .I3(\uut_Display/Digit12_out [0]),
        .I4(\uut_Display/Digit12_out [2]),
        .O(\Segment[0]_INST_0_i_2_n_0 ));
  (* SOFT_HLUTNM = "soft_lutpair41" *) 
  LUT5 #(
    .INIT(32'hA2A8A8AA)) 
    \Segment[3]_INST_0_i_3 
       (.I0(\Segment[6]_INST_0_i_10_n_0 ),
        .I1(\uut_Display/Digit12_out [1]),
        .I2(\uut_Display/Digit12_out [3]),
        .I3(\uut_Display/Digit12_out [0]),
        .I4(\uut_Display/Digit12_out [2]),
        .O(\Segment[3]_INST_0_i_3_n_0 ));
  LUT3 #(
    .INIT(8'h01)) 
    \Segment[4]_INST_0_i_8 
       (.I0(\uut_Display/Digit12_out [5]),
        .I1(\uut_Display/Digit12_out [4]),
        .I2(\uut_Display/Digit12_out [6]),
        .O(\Segment[4]_INST_0_i_8_n_0 ));
  (* SOFT_HLUTNM = "soft_lutpair42" *) 
  LUT5 #(
    .INIT(32'h8AAA888A)) 
    \Segment[5]_INST_0_i_2 
       (.I0(\Segment[6]_INST_0_i_10_n_0 ),
        .I1(\uut_Display/Digit12_out [3]),
        .I2(\uut_Display/Digit12_out [0]),
        .I3(\uut_Display/Digit12_out [1]),
        .I4(\uut_Display/Digit12_out [2]),
        .O(\Segment[5]_INST_0_i_2_n_0 ));
  LUT6 #(
    .INIT(64'h0000000101010101)) 
    \Segment[6]_INST_0_i_10 
       (.I0(\uut_Display/Digit12_out [6]),
        .I1(\uut_Display/Digit12_out [4]),
        .I2(\uut_Display/Digit12_out [5]),
        .I3(\uut_Display/Digit12_out [2]),
        .I4(\uut_Display/Digit12_out [1]),
        .I5(\uut_Display/Digit12_out [3]),
        .O(\Segment[6]_INST_0_i_10_n_0 ));
  (* SOFT_HLUTNM = "soft_lutpair42" *) 
  LUT5 #(
    .INIT(32'h4101FFFF)) 
    \Segment[6]_INST_0_i_3 
       (.I0(\uut_Display/Digit12_out [3]),
        .I1(\uut_Display/Digit12_out [2]),
        .I2(\uut_Display/Digit12_out [1]),
        .I3(\uut_Display/Digit12_out [0]),
        .I4(\Segment[6]_INST_0_i_10_n_0 ),
        .O(\Segment[6]_INST_0_i_3_n_0 ));
endmodule
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
