LuisDonatien/TFG/Programacion/SoCBasys3/Hw/BD/SoC/ip/SoC_Controlador_Motores_0_0/SoC_Controlador_Motores_0_0_sim_netlist.vhdl

-- Copyright 1986-2020 Xilinx, Inc. All Rights Reserved.
-- --------------------------------------------------------------------------------
-- Tool Version: Vivado v.2020.1 (win64) Build 2902540 Wed May 27 19:54:49 MDT 2020
-- Date        : Thu Jun  2 20:00:01 2022
-- Host        : LAPTOP-NOM20D60 running 64-bit major release  (build 9200)
-- Command     : write_vhdl -force -mode funcsim
--               c:/GitHubTFG/TFG/Programacion/SoCBasys3/BD/SoC/ip/SoC_Controlador_Motores_0_0/SoC_Controlador_Motores_0_0_sim_netlist.vhdl
-- Design      : SoC_Controlador_Motores_0_0
-- Purpose     : This VHDL netlist is a functional simulation representation of the design and should not be modified or
--               synthesized. This netlist cannot be used for SDF annotated simulation.
-- Device      : xc7a35tcpg236-1
-- --------------------------------------------------------------------------------
library IEEE;
use IEEE.STD_LOGIC_1164.ALL;
library UNISIM;
use UNISIM.VCOMPONENTS.ALL;
entity SoC_Controlador_Motores_0_0_CLOCK_DISPLAY is
  port (
    Segment : out STD_LOGIC_VECTOR ( 1 downto 0 );
    \STEP_reg[0]_0\ : out STD_LOGIC;
    STEP_s : out STD_LOGIC_VECTOR ( 1 downto 0 );
    \slv_reg5_reg[11]\ : out STD_LOGIC;
    Display : out STD_LOGIC_VECTOR ( 3 downto 0 );
    \slv_reg5_reg[10]\ : out STD_LOGIC;
    \STEP_reg[1]_0\ : out STD_LOGIC;
    \STEP_reg[1]_1\ : out STD_LOGIC;
    \STEP_reg[1]_2\ : out STD_LOGIC;
    \STEP_reg[1]_3\ : out STD_LOGIC;
    \STEP_reg[0]_1\ : out STD_LOGIC;
    Segment_1_sp_1 : in STD_LOGIC;
    \Segment[1]_0\ : in STD_LOGIC;
    \Segment[2]\ : in STD_LOGIC;
    O : in STD_LOGIC_VECTOR ( 0 to 0 );
    \Segment[1]_1\ : in STD_LOGIC;
    Q : in STD_LOGIC_VECTOR ( 3 downto 0 );
    \Segment[1]_2\ : in STD_LOGIC;
    \Segment[1]_3\ : in STD_LOGIC;
    \Segment[3]\ : in STD_LOGIC_VECTOR ( 0 to 0 );
    CO : in STD_LOGIC_VECTOR ( 0 to 0 );
    \Segment[6]\ : in STD_LOGIC_VECTOR ( 3 downto 0 );
    CLK : in STD_LOGIC
  );
  attribute ORIG_REF_NAME : string;
  attribute ORIG_REF_NAME of SoC_Controlador_Motores_0_0_CLOCK_DISPLAY : entity is "CLOCK_DISPLAY";
end SoC_Controlador_Motores_0_0_CLOCK_DISPLAY;

architecture STRUCTURE of SoC_Controlador_Motores_0_0_CLOCK_DISPLAY is
  signal \^display\ : STD_LOGIC_VECTOR ( 3 downto 0 );
  signal \STEP[0]_i_1_n_0\ : STD_LOGIC;
  signal \STEP[0]_i_2_n_0\ : STD_LOGIC;
  signal \STEP[0]_i_3_n_0\ : STD_LOGIC;
  signal \STEP[1]_i_10_n_0\ : STD_LOGIC;
  signal \STEP[1]_i_11_n_0\ : STD_LOGIC;
  signal \STEP[1]_i_12_n_0\ : STD_LOGIC;
  signal \STEP[1]_i_13_n_0\ : STD_LOGIC;
  signal \STEP[1]_i_14_n_0\ : STD_LOGIC;
  signal \STEP[1]_i_15_n_0\ : STD_LOGIC;
  signal \STEP[1]_i_18_n_0\ : STD_LOGIC;
  signal \STEP[1]_i_19_n_0\ : STD_LOGIC;
  signal \STEP[1]_i_1_n_0\ : STD_LOGIC;
  signal \STEP[1]_i_20_n_0\ : STD_LOGIC;
  signal \STEP[1]_i_21_n_0\ : STD_LOGIC;
  signal \STEP[1]_i_23_n_0\ : STD_LOGIC;
  signal \STEP[1]_i_24_n_0\ : STD_LOGIC;
  signal \STEP[1]_i_25_n_0\ : STD_LOGIC;
  signal \STEP[1]_i_26_n_0\ : STD_LOGIC;
  signal \STEP[1]_i_27_n_0\ : STD_LOGIC;
  signal \STEP[1]_i_28_n_0\ : STD_LOGIC;
  signal \STEP[1]_i_29_n_0\ : STD_LOGIC;
  signal \STEP[1]_i_31_n_0\ : STD_LOGIC;
  signal \STEP[1]_i_32_n_0\ : STD_LOGIC;
  signal \STEP[1]_i_33_n_0\ : STD_LOGIC;
  signal \STEP[1]_i_34_n_0\ : STD_LOGIC;
  signal \STEP[1]_i_36_n_0\ : STD_LOGIC;
  signal \STEP[1]_i_37_n_0\ : STD_LOGIC;
  signal \STEP[1]_i_38_n_0\ : STD_LOGIC;
  signal \STEP[1]_i_39_n_0\ : STD_LOGIC;
  signal \STEP[1]_i_40_n_0\ : STD_LOGIC;
  signal \STEP[1]_i_41_n_0\ : STD_LOGIC;
  signal \STEP[1]_i_43_n_0\ : STD_LOGIC;
  signal \STEP[1]_i_44_n_0\ : STD_LOGIC;
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
  signal \NLW_ltOp_inferred__2/i__carry__1_O_UNCONNECTED\ : STD_LOGIC_VECTOR ( 3 downto 0 );
  signal \NLW_ltOp_inferred__2/i__carry__2_CO_UNCONNECTED\ : STD_LOGIC_VECTOR ( 3 downto 1 );
  signal \NLW_ltOp_inferred__2/i__carry__2_O_UNCONNECTED\ : STD_LOGIC_VECTOR ( 3 downto 0 );
  attribute SOFT_HLUTNM : string;
  attribute SOFT_HLUTNM of \Display[0]_INST_0\ : label is "soft_lutpair31";
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
