LuisDonatien/TFG/(commit log)

2022-04-23 Subida Word Base de Datos
2022-04-24 Proyecto Con control de versiones
2022-04-25 Pulir Codigo PWM Generator
2022-04-25 Version Pulida PWM_Generator y simulada
2022-04-26 Creacion de Carpeta Pruebas
2022-05-01 Memoria TFG Avance de Estado del Arte
2022-05-17 Memoria Tabla de Registros
2022-06-02 Organizacion y modificacion carpeta programacion
    [SoC_Controlador_Motores_0_0.xml]
2022-06-13 Edicion de estilos y Fuentes
